HoodPaul/amiga-db23-alternative/README.md

# Amiga DB23 Video and Floppy Adapter

An adapter assembly for the Amiga's motherboard-mounted **DB23 RGB video and external floppy connectors**. A genuine solder-cup DB23 joins a small horizontal PCB, 23 supported straight pins and a solid printed base. Two screws clamp the assembly through the original motherboard mounting holes, with nuts above the adapter PCB and insulating washers under the motherboard-side heads. An optional cosmetic cover locates on the front towers and can be secured with tiny glue spots. **Mechanical/assembly revision: 0.6. PCB revision: 0.5.**

Project development: **Paul of UK Computing Limited**, **Jon of JMC Electronics** and **AI assistance through Codex**. This develops Paul's supplied straddle-PCB concept and supported loose-pin construction.

Repository: [HoodPaul/amiga-db23-alternative](https://github.com/HoodPaul/amiga-db23-alternative).

**Status, 30 October 2026: fit prototype. Paul has trial-printed revision 0.5 and reported delicate lid projections and nuts contained within the print footprint. The revised 0.6 parts have not yet been printed. The complete connector, fastener and PCB stack remains unmeasured. No physical strength, assembled electrical operation or Amiga compatibility test has been completed.** Native files and trial prints make those checks possible; this is not a production release.

For engineering or AI work, read [AGENTS.md](AGENTS.md), the [handover](docs/AI-HANDOVER.md) and [documentation index](docs/README.md).

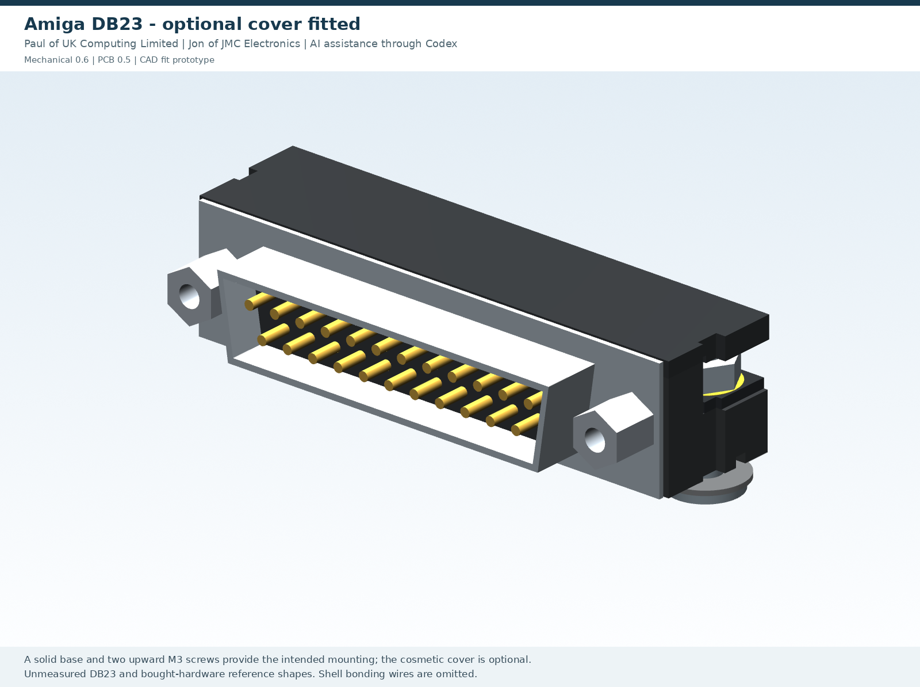
[picture p1: previews/assembly-isometric.png]
Assembly with black cap

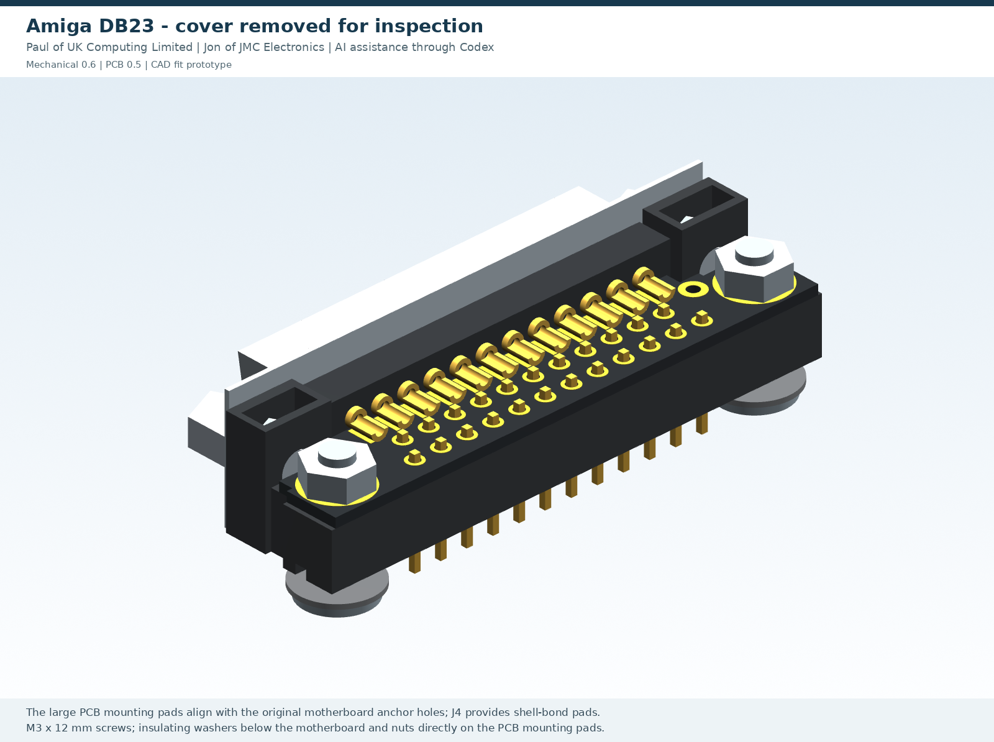
[picture p2: previews/assembly-cap-removed.png]
Assembly with cap removed

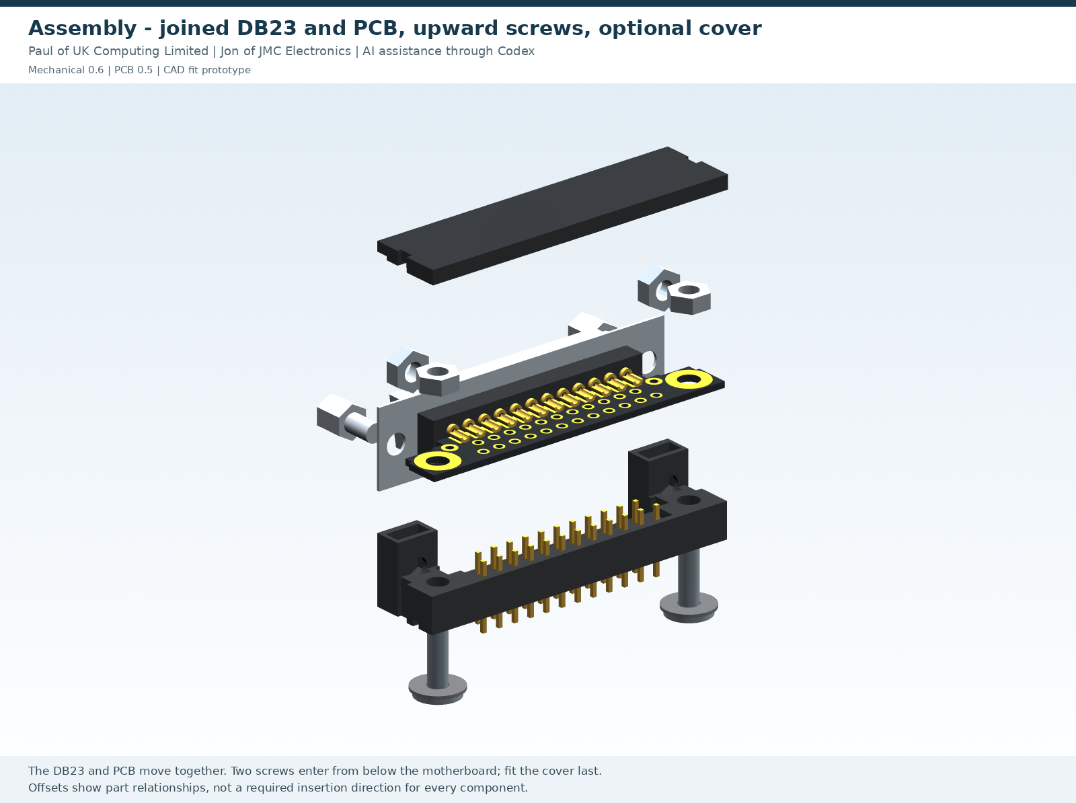
[picture p3: previews/assembly-exploded.png]
Exploded assembly

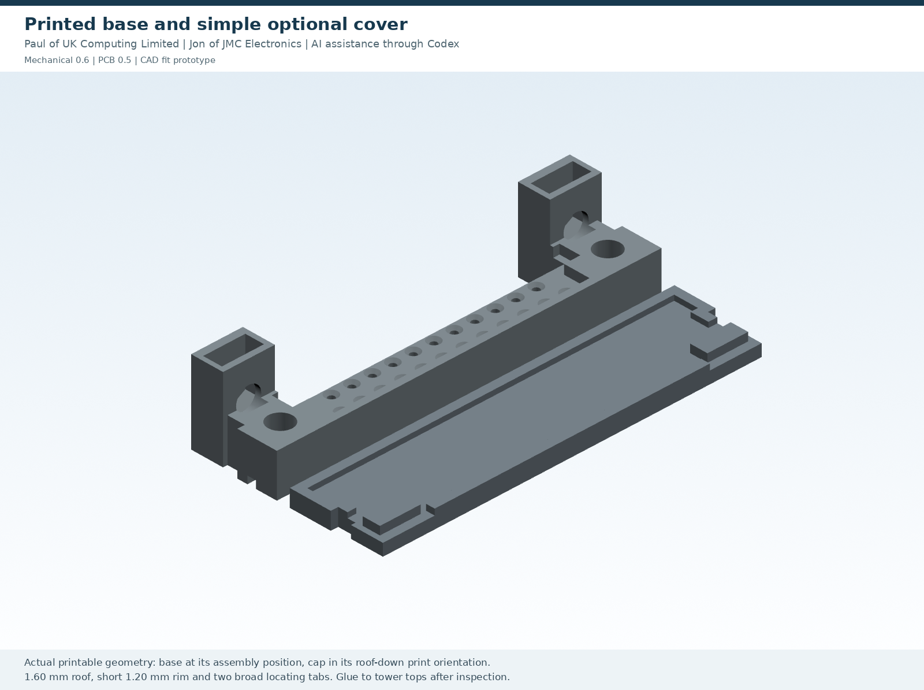
[picture p4: previews/base-and-cap.png]
Solid base and optional cover


The printed geometry comes from the delivered CAD. Bought connector bodies, cups, pins and hardware are unmeasured reference envelopes. Their appearance does not prove a purchased part fits. See the [drawing PDF](previews/DB23_Prototype_Drawings_v0.6.pdf) for fit references and assembly views.

## Revision 0.6 mechanical arrangement

The DB23 cups straddle the front of the PCB: contacts 1–12 solder to the top and 13–23 to the bottom. Twenty-three separate pins pass through the base into the original motherboard signal holes.

The PCB has side ears with plated `SHIELD` mounting lands at the original shell-anchor positions. **M3 screws enter from underneath the motherboard**, pass through the solid base and PCB, and take nuts on top, with insulating washers beneath the screw heads. The printed base has one broad, flat underside at motherboard Z0 and supports the PCB at Z5.75.

The forward towers have straight, square outer faces at X±25.60. Clearance for neighbouring components starts behind the towers.

Dedicated J4 shell-bond pads keep wire and solder away from the J3 nut-bearing lands. The cap fits last, after mounting and inspection. It provides the discreet black appearance; fitted jackposts must retain their nuts with the cover absent. The solid base and through-bolts carry the intended cable loads. Actual insertion strength and clamping behaviour remain untested.

The build order follows four parts: **join DB23 and PCB; load pins with the separate height jig and solder the joined assembly onto them; fit jackpost nuts and posts; mount and solder to the motherboard, inspect, then fit the cap.** See the [assembly guide](docs/ASSEMBLY.md).

## PCB variants

Open the matching project with **KiCad 7.0 or newer**:

| Variant | Native project | Connector on the Amiga |
|---|---|---|
| RGB video | [DB23M_RGB.kicad_pro](pcb/DB23M_RGB/DB23M_RGB.kicad_pro) | Male DB23 solder-cup connector |
| External floppy | [DB23F_Floppy.kicad_pro](pcb/DB23F_Floppy/DB23F_Floppy.kicad_pro) | Female DB23 solder-cup connector |

Local symbols and footprints are included. Male and female pin numbering is mirrored; use the matching PCB.

| PCB property | Revision 0.5 |
|---|---|
| Overall board envelope | **51.20 × 9.00 mm**, Y4.00–13.00, with mounting ears, front clearance steps and local reliefs |
| Layers / assumed thickness | **Two / 1.00 mm**; confirm the actual cup gap |
| Proposed finish | Black mask, white silkscreen, ENIG exposed pads |
| PCB legend, both faces | **Amiga DB23 REV 0.5**, nominal 0.70 mm text height / 0.10 mm stroke |
| Signal track / clearance | **0.50 / 0.20 mm** |
| Tail drill / pad | **1.04 / 1.70 mm** |
| J3 mounting drill / pad | **3.30 / 6.50 mm** |
| J4 shell-wire drill / pad | **1.20 / 2.40 mm** |
| Along-row pitch / spacing / stagger | **2.77 / 2.84 / 1.385 mm** |
| Front / rear signal rows | **Y8.08 / Y10.92 mm** from flange datum |
| Shell mounting centres | **44.27 mm**, at **Y9.50 mm** |
| Nominal mating centreline | **6.25 mm** above the motherboard |

The hole pattern and mating references are nominal values from the [iComp OEM-equivalent drawings](docs/SOURCES.md). The PCB rear is now Y13.00 rather than Y16.00, 3.00 mm shorter than revision 0.4. The cap reaches Y13.20, 0.70 mm behind the OEM reference rear at Y12.50. The prints are 52.00 mm wide, but the pair of Ø8 underside washers spans 52.27 mm. Actual side-exiting wire and case/component clearance still need checking on the target motherboard.

## Printed parts and mounting hardware

The [mechanical folder](mechanical/) contains editable OpenSCAD and the following trial parts:

- [Solid base STL](mechanical/DB23_Holder_v0.6.stl) and [STEP](mechanical/DB23_Holder_v0.6.step).
- [Optional cover STL](mechanical/DB23_Cap_v0.6.stl) and [STEP](mechanical/DB23_Cap_v0.6.step).
- [Pin-height jig](mechanical/DB23_Pin_Height_Jig_v0.6.stl) and [hole-fit coupon](mechanical/DB23_Hole_Fit_Coupon_v0.6.stl).

Read [mechanical notes](docs/MECHANICAL.md) and `mechanical/MECHANICAL_NOTES.txt` for orientations and fit allowances. The cap STL is already roof-down for printing; its STEP uses assembly coordinates. The base has a broad, flat Z0 underside for direct bed placement, subject to the usual first-layer and dimensional trial.

All 23 guides now have **0.40 mm deep, 45° entry funnels**, opening to **Ø1.72 mm** at the surface. This is two layers at 0.20 mm layer height, with the straight retaining bore preserved below. The cover has a **1.60 mm roof**, a short **1.20 mm rim**, and two broad locating tabs. The four thin projections, two hooks and their base catches are removed; obsolete clip coupons are removed too.

The default guides are nominally **Ø0.92 mm** for assumed **0.64 mm square pins**. Their diagonal is about **0.905 mm**, so a finished Ø0.80 mm round bore is too small. Establish snug pin retention using the coupon and actual pins. Use the funnel to guide careful hand clearing with a pin vice if needed. Hot insertion is unvalidated and can move or soften the guide. The loading jig sets a common lower-tip stop; equal upper heights also need equal pin lengths. Remove the jig before soldering.

The default motherboard fastener is **M3 × 12 mm under-head length**, with a user-listed **Ø7 mm, approximately 1 mm thick head**. Fit a **Ø8 mm insulating washer, assumed 0.50 mm thick, beneath each head**; the top nut bears directly on its supported J3 land. With an assumed 1.60 mm motherboard and 2.40 mm nut, the stack takes 11.25 mm, leaving 0.75 mm beyond the nut. The screw tip is Z9.90 and the head bottom Z−3.10, 1.50 mm beneath the assumed motherboard underside. Measure the real stack and underside/chassis clearance. **14 and 16 mm screws require trimming or separately checked cap clearance.** A top washer is not part of the default stack and needs a separate length check. No motherboard countersinking or drilling is specified.

Port jackposts need **4-40 UNC cable-facing threads** and rear stems matching the captive nuts. Prototype defaults use M3 rear stems and nuts. The clearance passage ends at Y6.20; the conservative permitted stem end is **Y≤6.00 from the flange datum**, before the upward mounting nuts. Select the actual hardware before freezing the print.

## Electrical arrangement and validation

All **23 positions pass independently, pin n to pin n**, using neutral `P01`–`P23` names. The bare PCB keeps `SHIELD` separate from every signal pin, including video pin 13. It adds no buffering, conversion, protection or change to the Amiga interface.

J3 mounting lands and J4 shell-wire pads share `SHIELD`. Provide deliberate wires or metal bonds from the DB23 shell and from J4 to the original motherboard shell-ground pad. The default head washers are insulating, and mounting-bolt contact is not relied upon for motherboard grounding. Plastic provides no grounding.

Use the [current validation record](docs/VALIDATION.md) for actual native DRC, exact-netlist and independent geometry results. Native schematic ERC is not claimed. CAD checks do not establish physical fit, printed strength, heat tolerance or working hardware.

Run the portable PCB audit from the project root:

```sh
python3 source/verify_pcb.py
```

Complete the [measurements](docs/MEASUREMENTS.md) and trial prints before a board order. Generated files under [fabrication/FIT-PROTOTYPE/](fabrication/FIT-PROTOTYPE/) are coordinated prototype exports, not a measured production release.

## Project contents

| Path | Purpose |
|---|---|
| [pcb/](pcb/) | Both KiCad projects and local libraries |
| [mechanical/](mechanical/) | Editable source, print trials and STEP geometry |
| [previews/](previews/) | Assembly, print and PCB views, drawing PDF |
| [docs/](docs/) | Assembly, measurements, design decisions and handover |
| [source/](source/) | Shared parameters, builders and verifiers |
| [verification/](verification/) | Actual native and saved-file reports |
| [BOM.csv](BOM.csv) | Parts and selection assumptions |
| [CHANGELOG.md](CHANGELOG.md) | Revision history |
| [NOTICE.md](NOTICE.md) | Project and third-party notices |

## Universal PCB prototype — ordered 30 October 2026

**Use the universal PCB at your own risk.** A separate [universal prototype package](pcb/DB23_Universal_Prototype/README.md) now includes editable PCB, Gerbers/drills, preview, checks and order records. It retains the existing physical routing, adds VIDEO 1 / FLOPPY 1 markings on both faces, removes other numbers and uses round signal pads. Internal numbering remains the VIDEO reference; actual connector orientation and continuity must be checked.

Paul confirmed ordering 30 boards from JLCPCB on 30 October 2026: two-layer FR-4, 1.00 mm, 1 oz, black mask, white silkscreen, ENIG. Receipt, physical fit and functional operation remain unverified. Native KiCad 10.0.7 DRC reports zero errors/unconnected items and four missing-library warnings; exact checks confirm 23 separate signal connections. This is a standalone board snapshot, not a new coordinated PCB revision or a replacement for the two existing variants.

### Hardware order update — 30 October 2026

Paul confirmed **30 PCBs** (correcting the earlier 20), **100 M3 × 12 mm screws with 7 mm heads**, **100 M3 304 stainless nuts**, and **40 strips of 1×40 L11.5 headers** (nominally 1,600 pins). See [the order details](pcb/DB23_Universal_Prototype/ORDER_RECORD_2026-10-30.md). The selected 11.5 mm pins are intended to be used untrimmed after carrier removal; nominal protrusion above the PCB is 1.55 mm and roof clearance 2.70 mm with the existing jig. Actual dimensions and fit are unverified; main CAD still models 10.70 mm pins. Earlier quoted prices apply to the original 20-board screenshot, not the final 30-board order.
