HoodPaul/amiga-db23-alternative/docs/README.md

# Documentation index

| Document | Purpose |
|---|---|
| [AI-HANDOVER.md](AI-HANDOVER.md) | Current decisions, geometry and remaining work |
| [MEASUREMENTS.md](MEASUREMENTS.md) | Worksheet for actual parts, stack and target Amiga |
| [MECHANICAL.md](MECHANICAL.md) | Solid base, upward mounting, cap, jig and pin fit |
| [ASSEMBLY.md](ASSEMBLY.md) | Four-part assembly and electrical inspection |
| [ELECTRICAL.md](ELECTRICAL.md) | Independent signal circuits and shell grounding |
| [FABRICATION.md](FABRICATION.md) | PCB/print preparation and prototype status |
| [DEVELOPMENT.md](DEVELOPMENT.md) | Coordinated regeneration and checks |
| [VALIDATION.md](VALIDATION.md) | Actual results and outstanding physical checks |
| [SOURCES.md](SOURCES.md) | Primary references and assumption boundaries |

Current mechanical/assembly revision: **0.6**. PCB revision: **0.5**. Start with the [project README](../README.md). The shared [parameters](../source/design_parameters.json) are the coordinate contract for native CAD, printed parts, hardware and previews.

Project development: **Paul of UK Computing Limited**, **Jon of JMC Electronics** and **AI assistance through Codex**.
