HoodPaul/amiga-db23-alternative/pcb/DB23_Universal_Prototype/README.md

# Universal DB23 PCB — experimental prototype

**USE THE UNIVERSAL PCB AT YOUR OWN RISK.** It has not been physically fitted or functionally tested on an Amiga. CAD checks and a PCB order do not establish compatibility or safe operation.

This separate board snapshot is based on PCB revision 0.5. It is intended for either a male RGB video solder-cup connector or a female external-floppy solder-cup connector, with the correct connector orientation. Both faces carry VIDEO 1 and FLOPPY 1 markers at their respective ends; other pin numbers are removed and all signal through-hole pads are round. The centre of each pin-1 label aligns with its rear-row through-hole.

Keep the same physical PCB orientation for either connector: 12-contact cups on the top face, 11-contact cups on the bottom, connector facing outwards. Confirm this against your actual connector. Bottom silkscreen is mirrored for reading from below. Internal pad/net numbers retain the VIDEO reference numbering; they are not floppy connector numbers. No universal schematic is supplied.

## Files and manufacture

- [Editable PCB](DB23_Universal_Prototype.kicad_pcb) and [project settings](DB23_Universal_Prototype.kicad_pro)
- [Manufacturing Gerber/drill ZIP](DB23_Universal_Prototype_Gerbers.zip); individual files in [Gerbers](Gerbers/)
- [Front preview](Preview/front.svg)
- [Order record](ORDER_RECORD_2026-10-30.txt)

Use two-layer FR-4, **1.00 mm thickness**, 1 oz copper. The ordered finish is black mask, white silkscreen and ENIG 1 microinch. Existing variant PCBs and mechanical files are unchanged. This snapshot is not regenerated by the main PCB builder.

## Status — 30 October 2026

Paul confirmed an order for **30 universal prototype PCBs from JLCPCB**. No receipt, delivery, physical fit or functional test is recorded. The screenshot quote was £17.16 for boards plus £1.12 estimated shipping; final payment and order number were not supplied. Quoted build was 3 days and shipping 8–12 business days; these are not confirmed delivery dates.

## Checks and limitations

KiCad 10.0.7 loaded the board and ran native DRC: zero errors and zero unconnected items; four warnings concern the absent DB23_Local footprint library. Embedded footprints are included in the PCB. No geometry or silkscreen violations were reported. Schematic parity and ERC were not run.

[integrity.json](integrity.json) confirms the unchanged 26 tracks and outline, 50 pads and only the intended square-to-round pad change. [connection-check.json](connection-check.json) verifies all 23 independent J1-to-J2 signal nets. [Native DRC report](drc.json) is retained. Exports used kicad-cli pcb export gerbers, drill and svg; DRC used kicad-cli pcb drc --format json. Local commands logged registry/configuration warnings, but output files and the DRC report were produced.

Check actual connector numbering, all 23 end-to-end connections, isolation between signals, separate SHIELD wiring, mechanical clearances and mounting insulation before powering hardware. Retain the deliberate connector-shell and motherboard shell-ground bonds described in the main assembly instructions.

Project development: Paul of UK Computing Limited, Jon of JMC Electronics and AI assistance through Codex.

### Hardware order update — 30 October 2026

Paul confirmed **30 PCBs** (correcting the earlier 20), **100 M3 × 12 mm screws with 7 mm heads**, **100 M3 304 stainless nuts**, and **40 strips of 1×40 L11.5 headers** (nominally 1,600 pins). See [the order details](ORDER_RECORD_2026-10-30.md). The selected 11.5 mm pins are intended to be used untrimmed after carrier removal; nominal protrusion above the PCB is 1.55 mm and roof clearance 2.70 mm with the existing jig. Actual dimensions and fit are unverified; main CAD still models 10.70 mm pins. Earlier quoted prices apply to the original 20-board screenshot, not the final 30-board order.
