HoodPaul/amiga-db23-alternative/source/requirements-previews.txt

# Python dependencies for the mechanical build/audit and CAD previews/PDF.
# CadQuery is required by build_mechanical.py; the independent audit also needs VTK.
# Pillow and ReportLab support previews and drawings. OpenSCAD is installed separately.
# The portable PCB audit uses only Python's standard library.
cadquery>=2.4
vtk>=9.2
Pillow>=10
reportlab>=4
