HoodPaul/amiga-db23-alternative/previews/DB23_Prototype_Drawings_v0.6.pdf

AMIGA DB23 PROJECT

Paul of UK Computing Limited | Jon of JMC Electronics | AI assistance through Codex

# DB23 replacement assembly

Mechanical 0.6 / PCB 0.5: solid printed base and optional cosmetic cover


30 October 2026 | Mechanical 0.6 / PCB 0.5 | Fit prototype | 1 / 5

The revision 0.6 mechanical assembly uses two metal screws from beneath the motherboard, through a solid base and the adapter PCB, with insulating washers below the motherboard and nuts above the adapter PCB. The optional cover conceals the hardware. Fitted jackposts must retain their nuts without the cover; check the actual assembly.

Adapter PCB overall width / depth | 51.20 / 9.00 mm (Y4.00-13.00)
PCB thickness / underside height | 1.00 mm / Z5.75 mm assumed
Printed base width / rear position | 52.00 mm / Y13.00 mm
Printed cap width / rear position | 52.00 mm / Y13.20 mm
Original shell mounting centres | 44.27 mm; Y9.50 mm

OEM comparison: iComp's original-equivalent drawing has a 50.27 mm width and 12.50 mm depth behind the flange datum. The present printed envelope is 52.00 mm wide and reaches Y13.20: +0.865 mm per side and +0.70 mm at the rear. The signal-hole pattern and nominal mating centreline are retained.

Fit prototype: purchased connector, printed fit, clamping, underside clearance and cable-load strength remain unverified. The DB23 body, cups and bought hardware in the views are explicitly assumed reference shapes.

# The two printed parts

A solid base carries the PCB; the optional cover glues to the tower tops

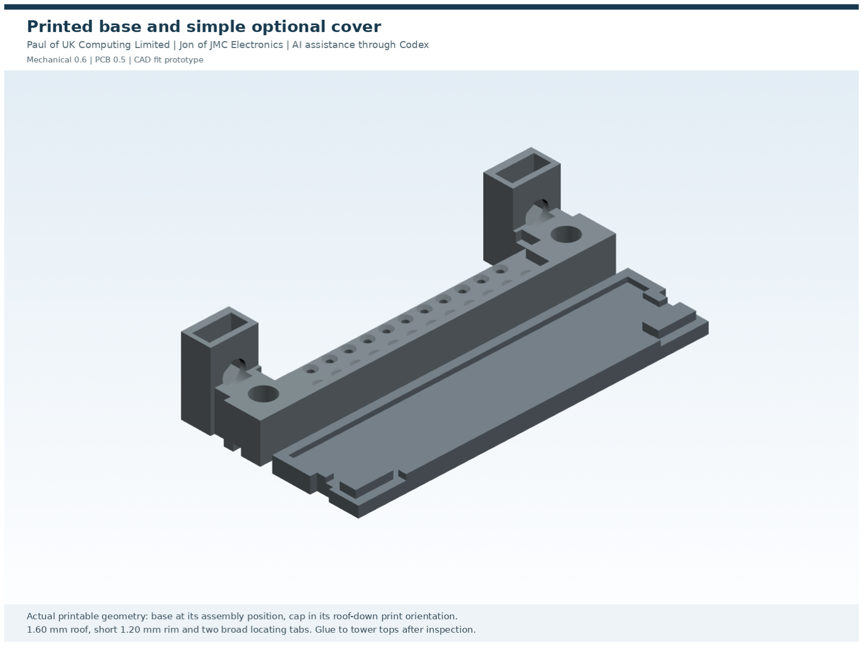
[picture p5: figure]
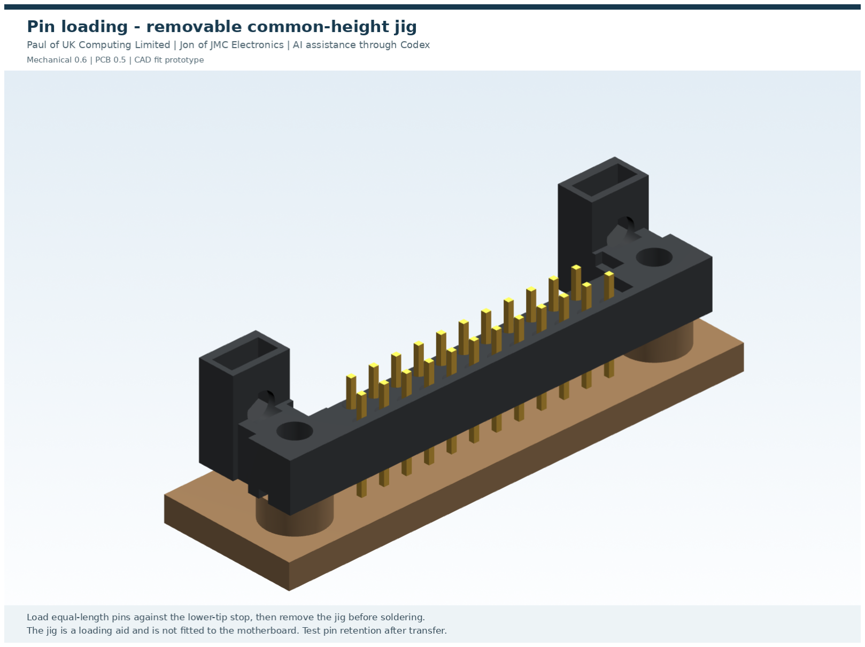
[picture p6: figure]

30 October 2026 | Mechanical 0.6 / PCB 0.5 | Fit prototype | 2 / 5

The squared forward ends have flat X+/-25.60 outer faces, with 0.60 mm added at the former rear-corner rebates. The complete underside is lowered to a coplanar Z0 surface; there are no projecting feet or separate shims. All 23 guide entries have a 0.40 mm deep, 45-degree funnel. The guide retains a 1.25 mm gap below the PCB.

Load the pins first

Print the chamfered hole-fit coupon before the full base. The trial guide diameter is 0.92 mm for assumed 0.64 mm square pins; their diagonal is 0.905 mm. A finished 0.80 mm bore does not clear them.

Use the separate loading jig to set the lower tips. Equal 10.70 mm pins span Z-3.20 to Z7.50. Remove the jig before soldering and check that the base retains the pins.

Printing: the base, cap, jig and hole coupon are trial parts. Follow the mechanical notes for print orientations and cap assembly transforms. The cover has a 1.60 mm roof, 1.20 mm short rim and two broad locating tabs. Four thin projections and both hooks are removed. Trial print fit and tiny glue spots on the tower tops.

# Assembly in four parts

The DB23 and PCB stay joined; upward mounting screws are fitted during installation

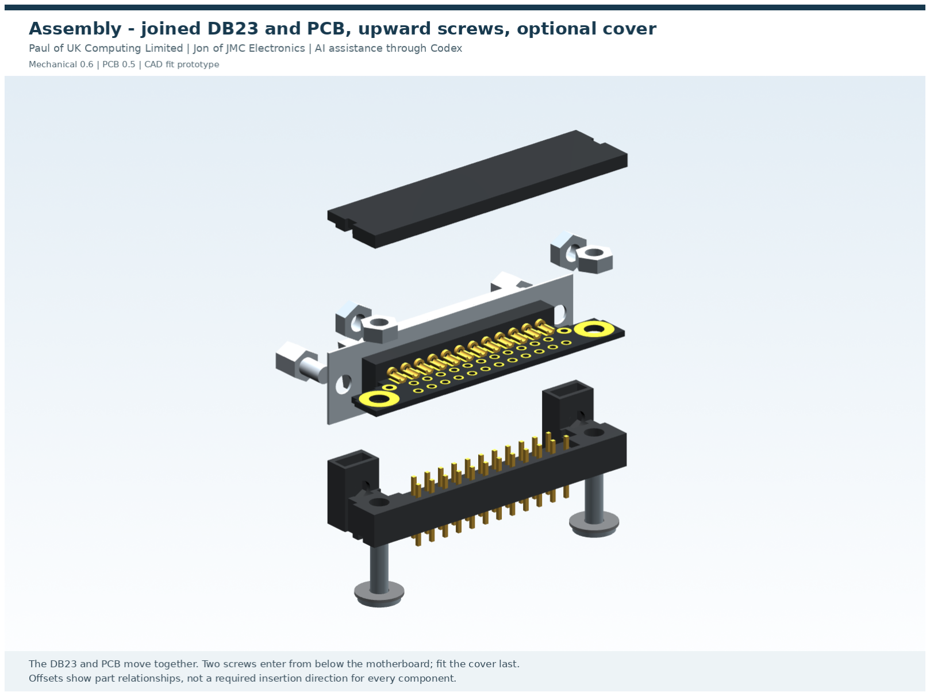
[picture p7: figure]

30 October 2026 | Mechanical 0.6 / PCB 0.5 | Fit prototype | 3 / 5

Part 1 - Join the DB23 and PCB

Identify the matching male or female pin numbers. Solder both rows of cups to the PCB away from the printed base. Prepare the shell bond at the dedicated J4 pads and finish any covered underside joints.

Part 2 - Load pins, then lower the joined assembly

Load equal-length pins into the base using the height jig. Remove the jig, retain the pins in a heat-safe fixture and lower the complete DB23 + PCB from above. Seat the PCB fully, then solder all 23 pin tops.

Part 3 - Fit the jackpost hardware

Insert the jackpost nuts and fit the hex posts through the connector flange. Check actual flange bearing, nut fit and rear stem projection. Leave the decorative cap off while fitting and checking the mounting hardware.

Part 4 - Mount, solder, check, then cap

Check all 23 circuits off the motherboard. Pre-tack the motherboard shell-pad lead with the base removed, then route it through the recessed right-side base channel. Install screws upwards from below, with insulating washers below the motherboard and nuts on the PCB mounting pads. Secure the supported stack, solder the motherboard tails and complete the shell bond. Inspect and test, then optionally attach the cover with tiny glue spots on the tower tops, away from contacts and hardware.

# Upward screw mounting stack

Nominal dimensions only; the actual motherboard, washer and nut must be measured

30 October 2026 | Mechanical 0.6 / PCB 0.5 | Fit prototype | 4 / 5
Motherboard thickness assumed | 1.60 mm
Motherboard top to PCB underside | 5.75 mm
Adapter PCB thickness | 1.00 mm
Underside insulating washer | 0.50 mm
Nut height; no top washer | 2.40 mm
Total under head to top of nut | 11.25 mm

Optional cover roof

M3 x 12 tip: Z9.90

Nut directly on PCB pad

Solid base / supported PCB

Motherboard

Head + insulating washer
Local section enlarged; geometry simplified

### Length selection

Screw length below head | Projection past nut / tip height
12.00 mm - default | 0.75 mm / Z9.90
14.00 mm | 2.75 mm / Z11.90
16.00 mm | 4.75 mm / Z13.90

Cap clearance: the default 12 mm screw ends at Z9.90, below the nominal roof underside at Z11.00. Untrimmed 14 mm and 16 mm screws project into the cover envelope and are not default-compatible. Changing the insulating washer, nut, board thickness or cap geometry requires rechecking the complete stack.

Original holes only: the 7 mm head sits over an 8 mm insulating washer. Allow 1.50 mm total projection below the motherboard. Verify chassis and copper clearance; the shell bond remains a separate wire connection. The washer pair spans 52.27 mm: 0.135 mm beyond each side of the 52 mm print. Do not countersink the motherboard. Wire routing and actual chassis clearance still need a fit check.

# Pin templates and fit worksheet

Print this page at 100% / Actual size with no page scaling

30 October 2026 | Mechanical 0.6 / PCB 0.5 | Fit prototype | 5 / 5

Motherboard top view; connector faces the top of the page

Signal holes and shell anchors retain the original nominal grid. J4 belongs to the adapter only.

MALE / RGB

12 | 1
23 | 13

Blue: adapter outline and J4 holes

FEMALE / FLOPPY

1 | 12
13 | 23

Blue: adapter outline and J4 holes

### 50.00 mm scale check

### Measure before fabrication or final assembly

Purchased DB23 part / gender | ____________________________
Cup gap / cup length / body depth | ____________________________
Actual motherboard / PCB thickness | ____________________________
Pin section / finished bore / retention | ____________________________
Jackpost rear thread / stem projection | ____________________________
Nut AF / thickness / pocket fit | ____________________________
Upward screw / washer / nut stack | ____________________________
Head bearing / underside chassis gap | ____________________________
Cover fit / glue spots / tip clearance | ____________________________
Shell bond / clamping / insertion trial | ____________________________

Coordinate system: X runs across the connector; Y points inward from the flange front plane; Z is measured upward from the motherboard top. Male pin 1 is at positive X in this top view; female numbering is mirrored. The pin pitch is 2.77 mm, row spacing 2.84 mm and row stagger 1.385 mm.

Sources: original nominal connector grid and envelope: iComp DB23 replacement drawings. All selected design choices and unmeasured envelopes are in source/design_parameters.json. See docs/VALIDATION.md for actual saved-file checks and the physical work still outstanding.
