HoodPaul/amiga-db23-alternative/previews/holder-isometric.png

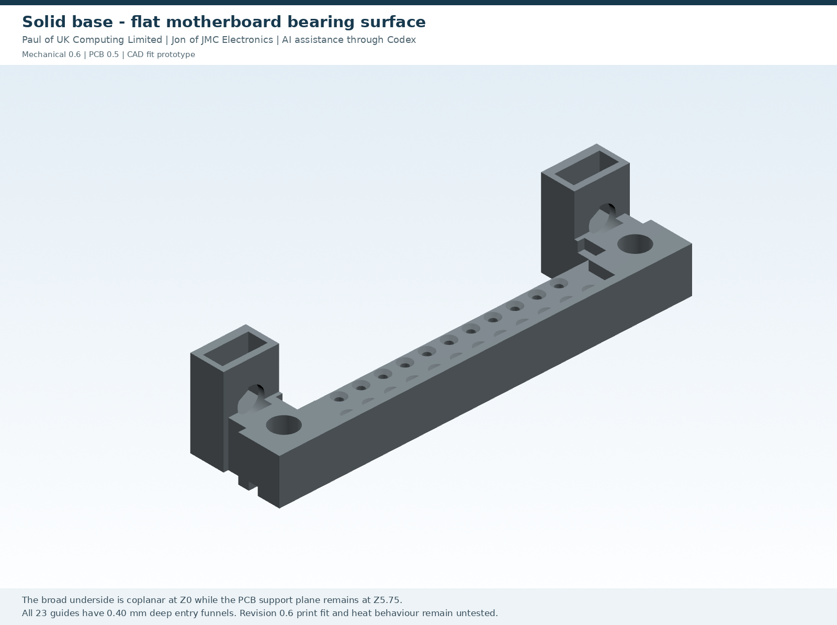
previews/holder-isometric.png
