HoodPaul/amiga-db23-alternative/previews/pcb-female-bottom.png

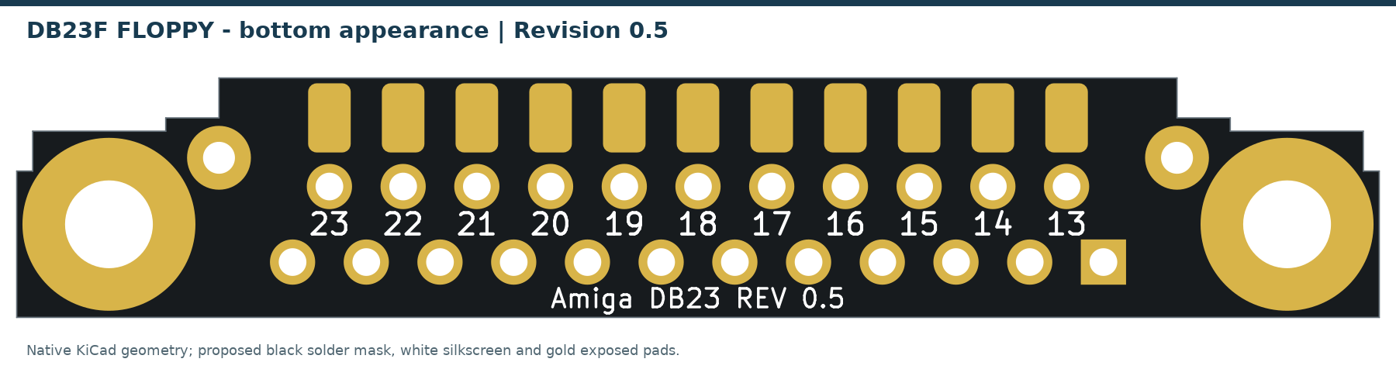
previews/pcb-female-bottom.png
