HoodPaul/amiga-db23-alternative/previews/pcb-female-top.png

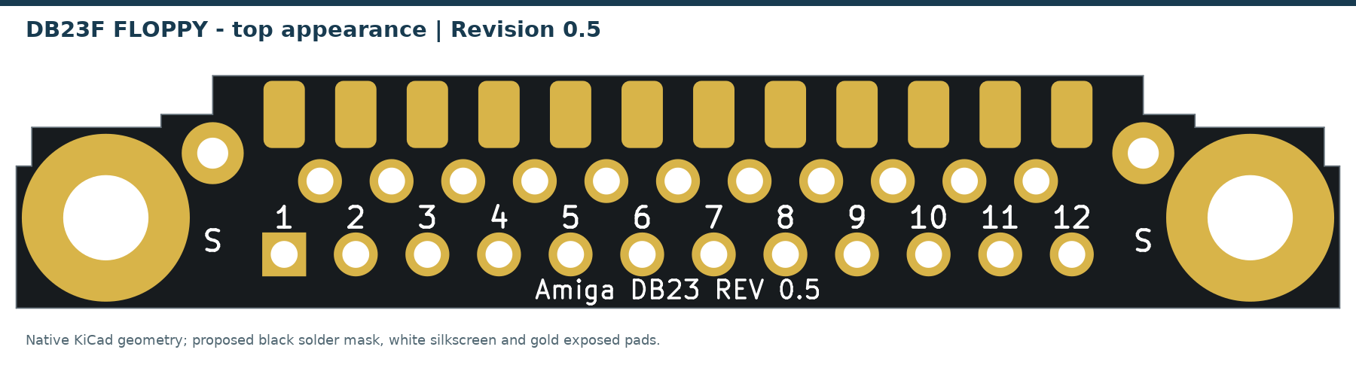
previews/pcb-female-top.png
