HoodPaul/amiga-db23-alternative/previews/pcb-male-bottom.png

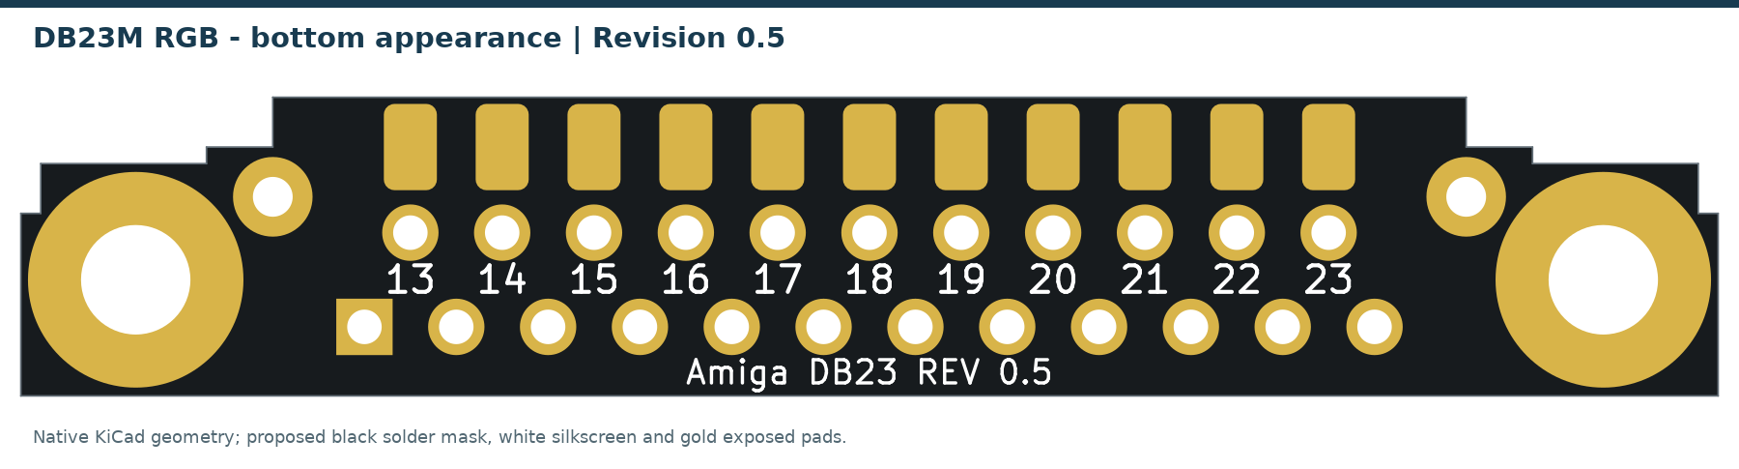
previews/pcb-male-bottom.png
