HoodPaul/amiga-db23-alternative/previews/pcb-male-top.png

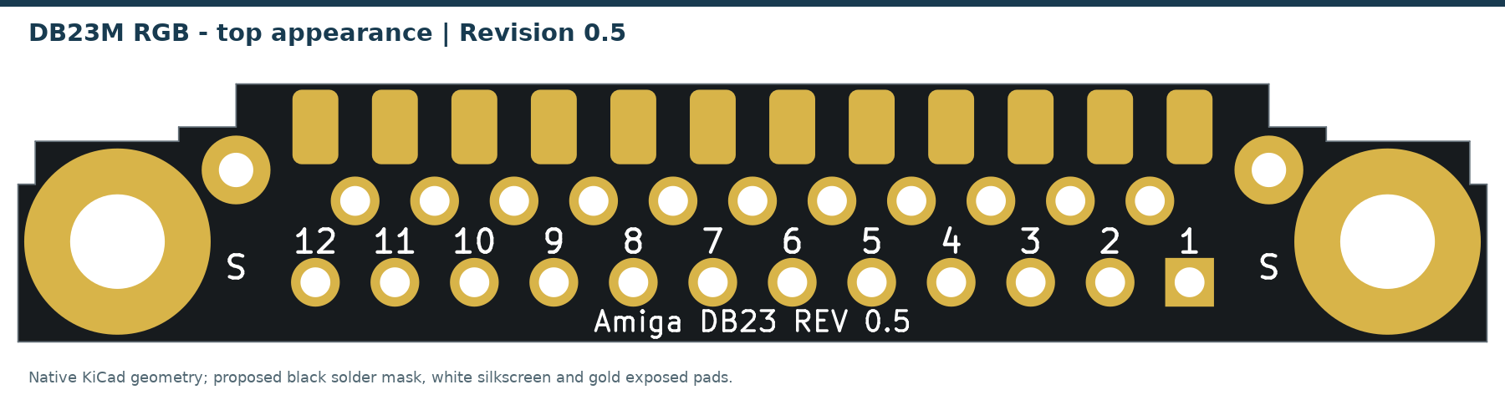
previews/pcb-male-top.png
