HoodPaul/amiga-db23-alternative/previews/pin-height-jig.png

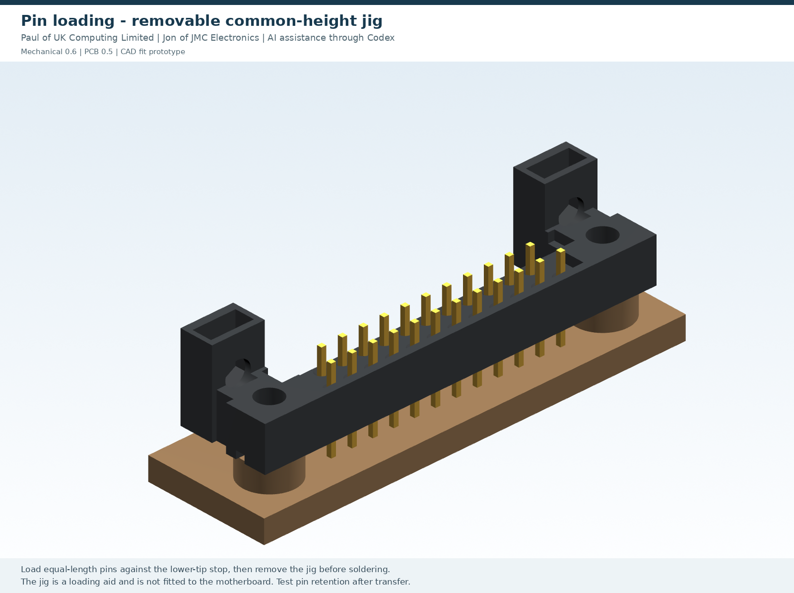
previews/pin-height-jig.png
