HoodPaul/amiga-db23-alternative/pcb/DB23_Universal_Prototype/ORDER_RECORD_2026-10-30.md

# Prototype PCB and hardware orders — 30 October 2026

Orders reported by Paul; receipt and physical checks are pending.

| Item | Selected option | Quantity |
|---|---|---|
| JLCPCB universal PCBs | 51.2 × 9 mm, 2 layers, 1.00 mm FR-4, 1 oz, black mask, white silk, ENIG | **30 boards** |
| [Screws](https://www.aliexpress.com/item/1005009412452370.html) | M3 × 12 mm, 7 mm ultra-thin flat head; nickel-plated steel listing | 2 × 50 = **100 screws** |
| [Hex nuts](https://www.aliexpress.com/item/4000152457370.html) | M3, 304 stainless steel; DIN934 listing | 2 × 50 = **100 nuts** |
| [Pin headers](https://www.aliexpress.com/item/1005008747214913.html) | 1 × 40, 2.54 mm pitch, **L11.5** | 2 × 20 = **40 strips**, nominally **1,600 pins** |

The PCB quantity corrects the earlier record of 20. Earlier quoted PCB and shipping prices relate to the 20-board screenshot and are not the final price for 30 boards. Order numbers, final charges and delivery dates were not supplied. Product options are recorded from Paul's supplied descriptions, not independently verified seller specifications.

## DB23 connector order

Paul also confirmed ordering **5 male and 5 female DB23 connectors** from [this AliExpress listing](https://www.aliexpress.com/item/1005012138133288.html). DB23 was explicitly confirmed after a DB21 typo. This initial quantity supports five video and five floppy prototypes, subject to actual connector fit. Receipt, dimensions and compatibility remain unverified.

## Selected 11.5 mm pins

Use 23 equal-length pins per adapter, untrimmed after removing the plastic carrier. The nominal 0.64 mm square section remains a design assumption to confirm on arrival.

With the existing jig lower-tip stop at Z−3.20, 11.50 mm pins end at Z8.30: **1.55 mm above the nominal PCB top at Z6.75**, leaving **2.70 mm to the lid roof underside at Z11.00**. These are nominal arithmetic clearances, not a physical or regenerated CAD pass. Check solder joints, connector cups and actual lid fit. Main CAD source still models 10.70 mm pins.

Two screws, two nuts and 23 pins are required per adapter: these quantities cover 30 boards with spares. Under-head insulating washers remain required; this update records no washer purchase.

**Use the universal PCB at your own risk.** Connector fit, mounting hardware dimensions, completed assembly and operation remain unverified.
