HoodPaul/amiga-db23-alternative/mechanical/DB23_Cap_v0.6_PCB_support.step

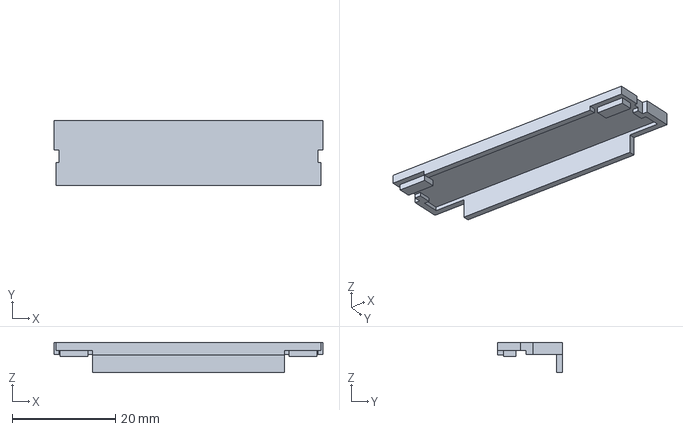
[picture p14: CAD file, 2026-10-30]
mechanical/DB23_Cap_v0.6_PCB_support.step
52.0 x 12.5 x 5.85 mm
