HoodPaul/amiga-db23-alternative/previews/reference-meshes/pcb-reference.stl

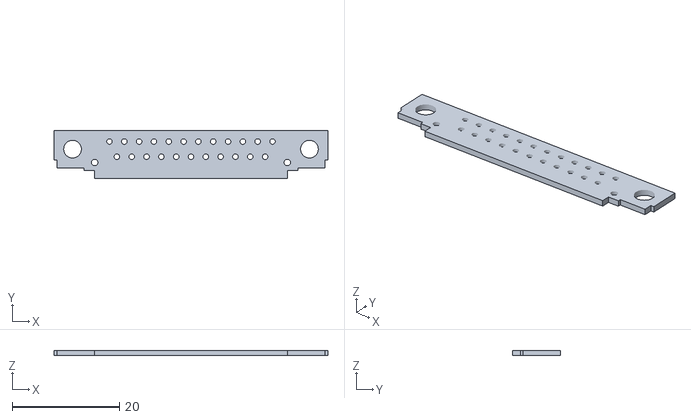
[picture p15: CAD file, 2026-10-29]
previews/reference-meshes/pcb-reference.stl
51.2 x 9.00 x 1.00
