HoodPaul/amiga-db23-alternative/mechanical/DB23_Pin_Height_Jig_v0.6.step

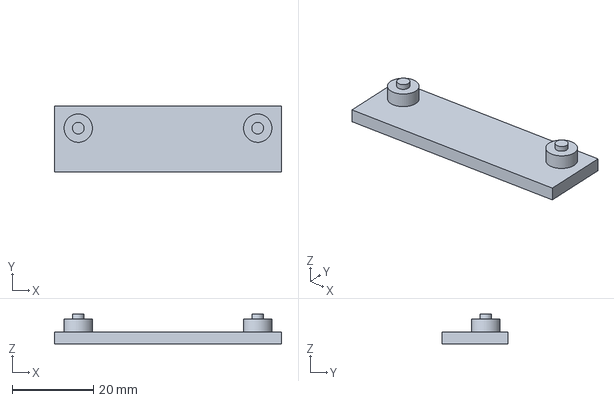
[picture p16: CAD file, 2026-10-30]
mechanical/DB23_Pin_Height_Jig_v0.6.step
56.0 x 16.4 x 7.40 mm
