HoodPaul/amiga-db23-alternative/mechanical/DB23_Holder_v0.6.step

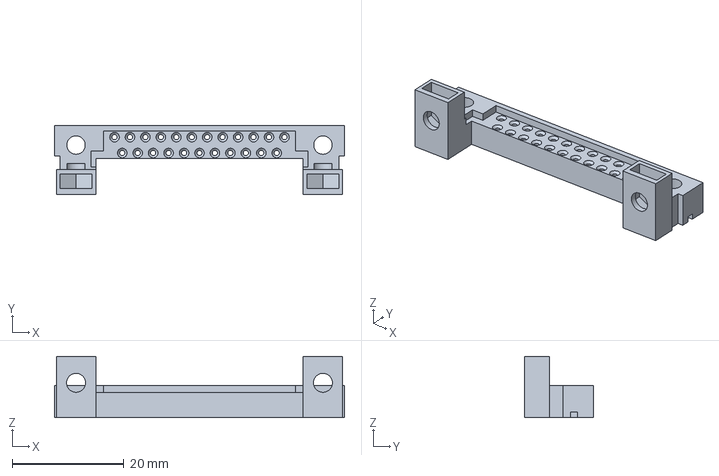
[picture p17: CAD file, 2026-10-30]
mechanical/DB23_Holder_v0.6.step
52.0 x 12.3 x 11.0 mm
