HoodPaul/amiga-db23-alternative/previews/reference-meshes/top-mounting-nuts-reference.stl

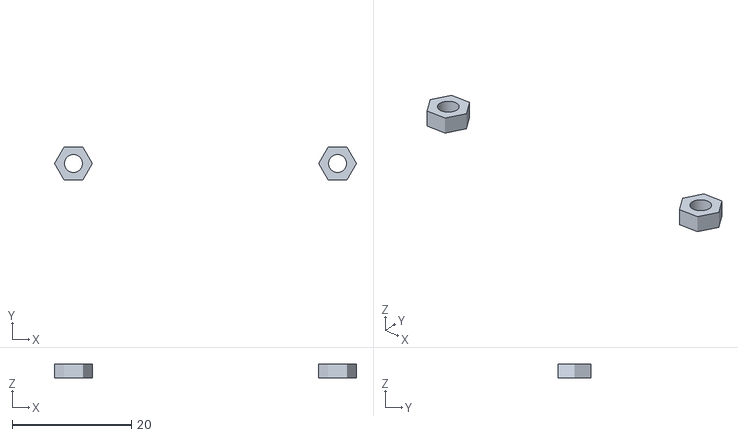
[picture p18: CAD file, 2026-10-29]
previews/reference-meshes/top-mounting-nuts-reference.stl
50.6 x 5.50 x 2.40
