HoodPaul/amiga-db23-alternative/mechanical/DB23_Hole_Fit_Coupon_v0.6.stl

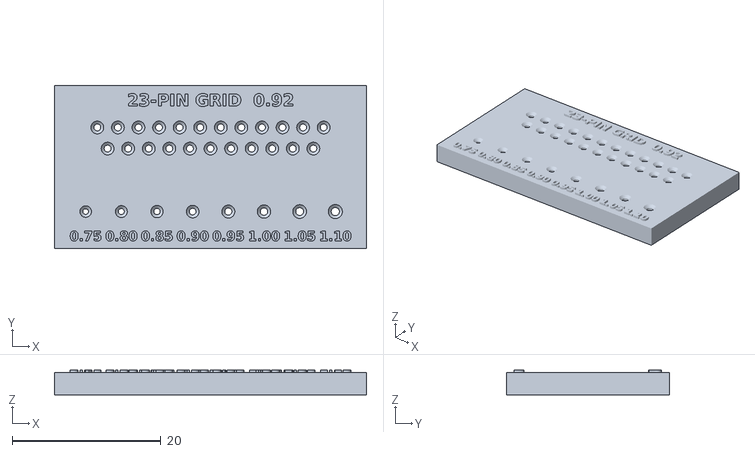
[picture p19: CAD file, 2026-10-30]
mechanical/DB23_Hole_Fit_Coupon_v0.6.stl
42.0 x 22.0 x 3.35
