HoodPaul/amiga-db23-alternative/previews/reference-meshes/jackpost-nuts-reference.stl

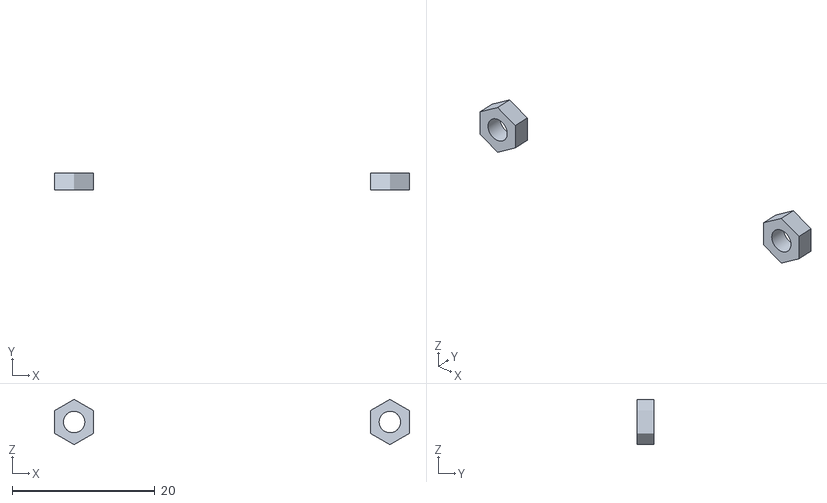
[picture p20: CAD file, 2026-10-29]
previews/reference-meshes/jackpost-nuts-reference.stl
49.8 x 2.40 x 6.35
