HoodPaul/amiga-db23-alternative/mechanical/DB23_Cap_v0.6.step

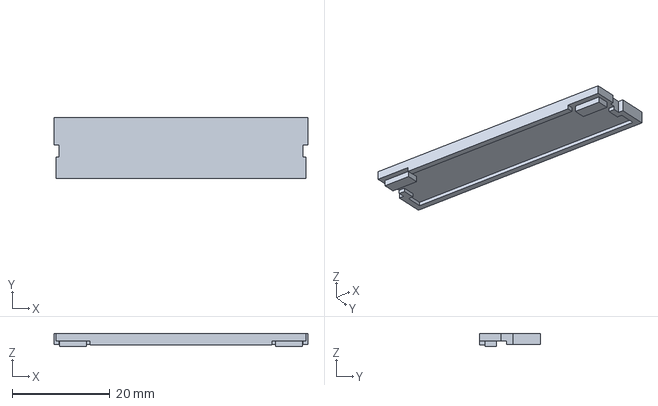
[picture p21: CAD file, 2026-10-30]
mechanical/DB23_Cap_v0.6.step
52.0 x 12.5 x 2.70 mm
