HoodPaul/amiga-db23-alternative/previews/reference-meshes/23-db23-contacts-reference.stl

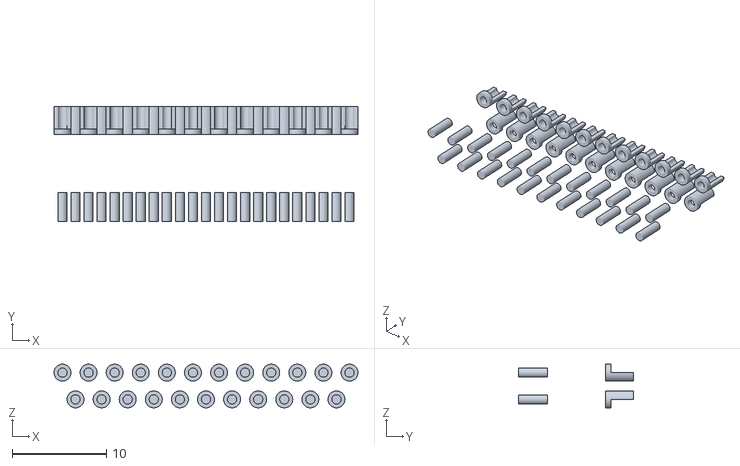
[picture p22: CAD file, 2026-10-29]
previews/reference-meshes/23-db23-contacts-reference.stl
32.3 x 12.2 x 4.64
