HoodPaul/amiga-db23-alternative/previews/reference-meshes/jackposts-reference.stl

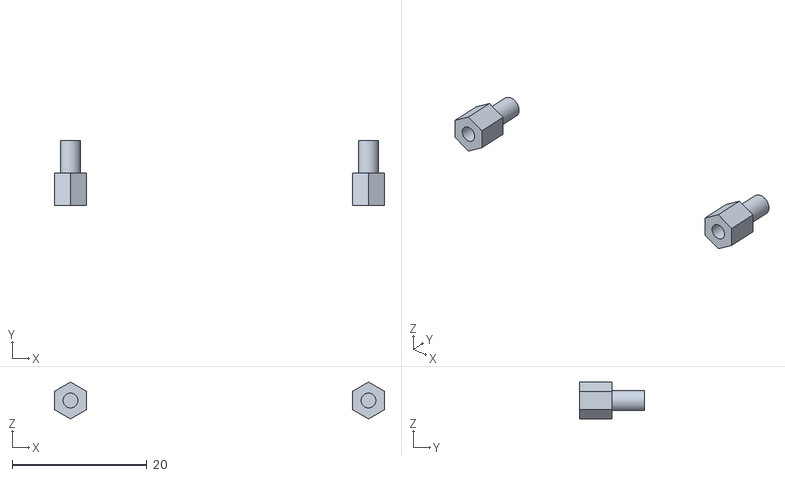
[picture p23: CAD file, 2026-10-29]
previews/reference-meshes/jackposts-reference.stl
49.0 x 9.60 x 5.48
