HoodPaul/amiga-db23-alternative/previews/reference-meshes/db23-metal-reference.stl

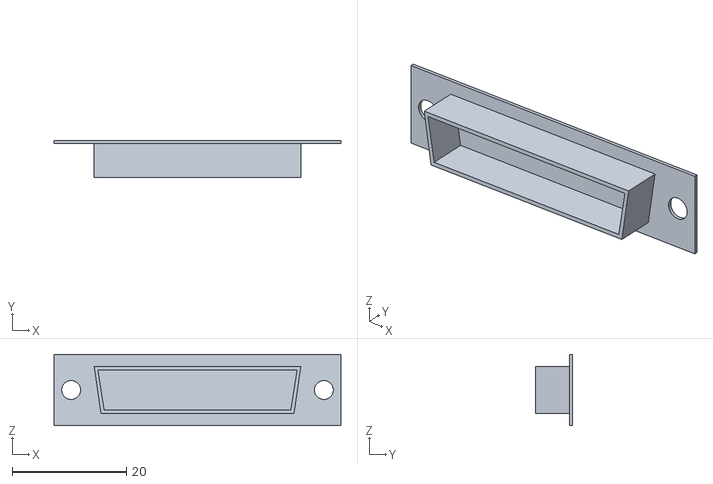
[picture p24: CAD file, 2026-10-29]
previews/reference-meshes/db23-metal-reference.stl
50.3 x 6.50 x 12.5
