HoodPaul/amiga-db23-alternative/previews/reference-meshes/exposed-pad-reference.stl

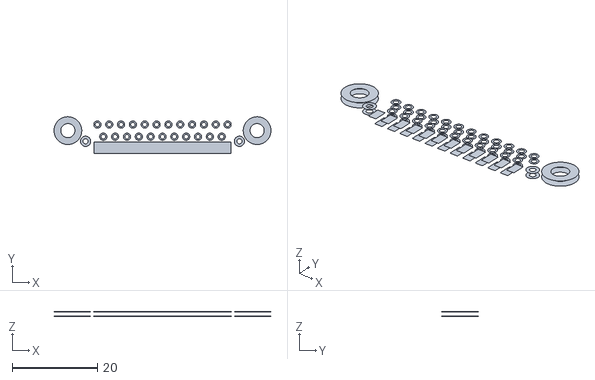
[picture p25: CAD file, 2026-10-29]
previews/reference-meshes/exposed-pad-reference.stl
50.8 x 8.55 x 1.09
