HoodPaul/amiga-db23-alternative/previews/reference-meshes/db23-insulator-reference.stl

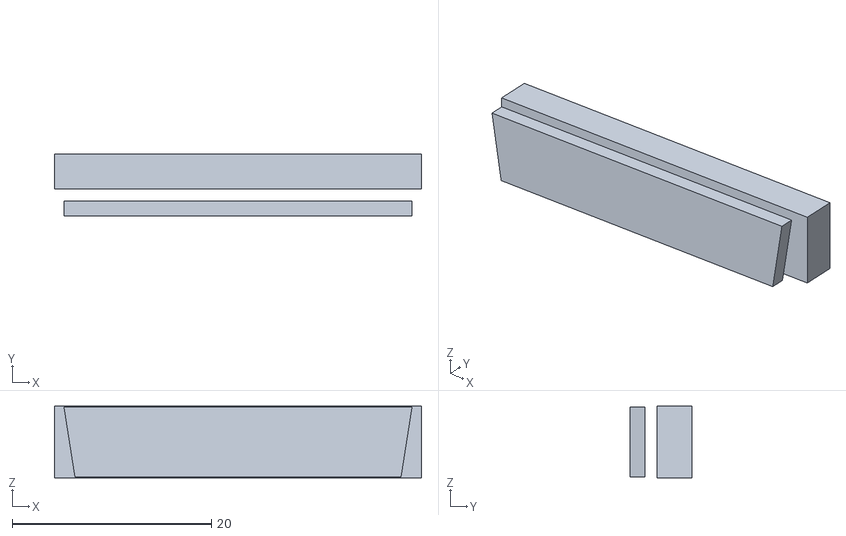
[picture p26: CAD file, 2026-10-29]
previews/reference-meshes/db23-insulator-reference.stl
36.8 x 6.20 x 7.20
