HoodPaul/amiga-db23-alternative/previews/reference-meshes/23-tail-pins-reference.stl

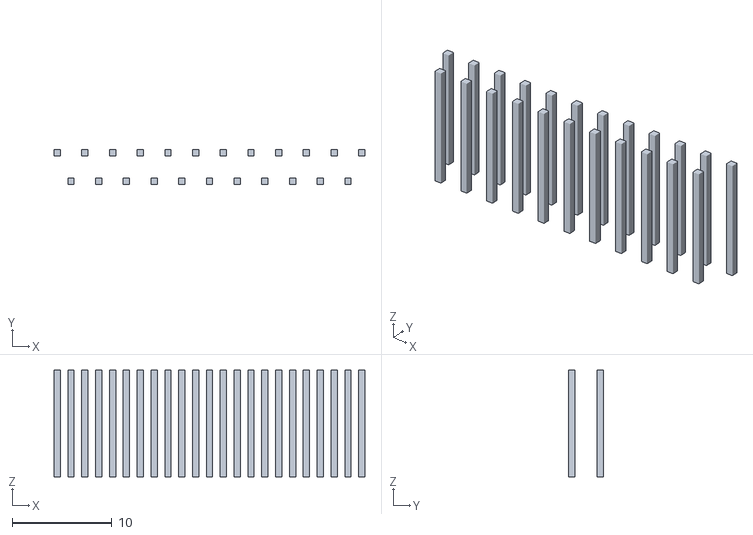
[picture p27: CAD file, 2026-10-29]
previews/reference-meshes/23-tail-pins-reference.stl
31.1 x 3.48 x 10.7
