HoodPaul/amiga-db23-alternative/previews/reference-meshes/upward-M3x12-screws-reference.stl

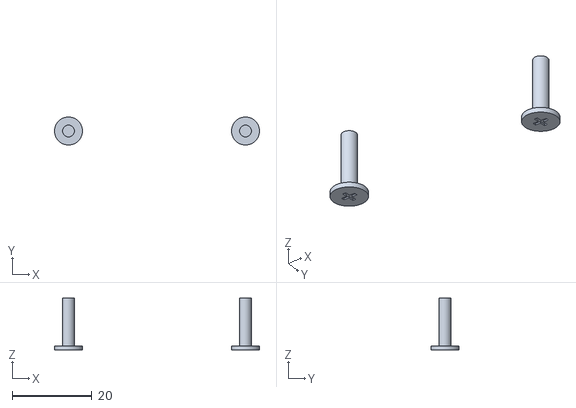
[picture p28: CAD file, 2026-10-29]
previews/reference-meshes/upward-M3x12-screws-reference.stl
51.3 x 7.00 x 13.0
