HoodPaul/amiga-db23-alternative/previews/reference-meshes/underside-insulating-washers-reference.stl

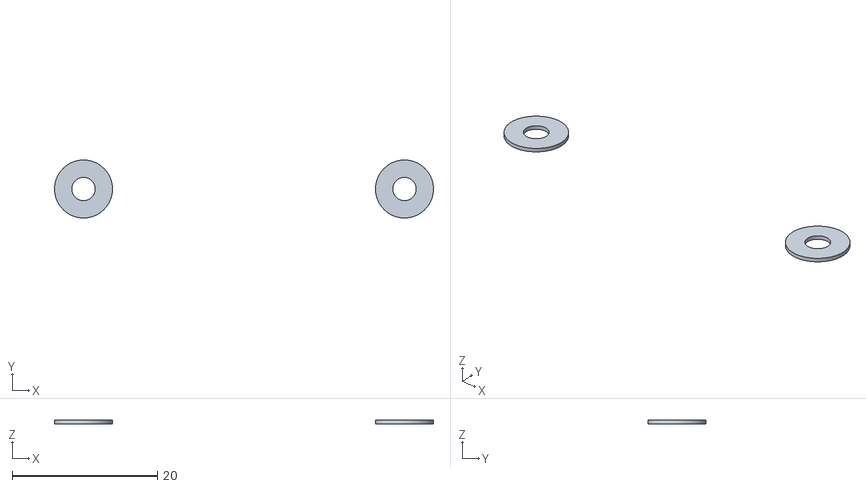
[picture p29: CAD file, 2026-10-29]
previews/reference-meshes/underside-insulating-washers-reference.stl
52.3 x 8.00 x 0.5
