HoodPaul/amiga-db23-alternative/mechanical/DB23_Cap_v0.6_PCB_support.scad

// DB23 v0.6 alternative lid with PCB support wall. Fit prototype.
// Standalone snapshot recovered from the checked central-wall correction.
// Default: roof-down print coordinates. Set assembly=true for STEP alignment.
assembly=false;
module cap_assembly(){
 difference(){
  union(){
   translate([-26.0, 0.65, 11.0]) cube([52.0, 12.549999999999999, 1.5999999999999996]);
   translate([-18.6, 0.65, 10.2]) cube([37.2, 1.2000000000000002, 0.8300000000000001]);
   translate([-26.0, 12.0, 10.3]) cube([52.0, 1.1999999999999993, 0.7299999999999986]);
   translate([-18.6, 12.0, 6.75]) cube([37.2, 1.1999999999999993, 4.279999999999999]);
   translate([-26.0, 7.5, 10.3]) cube([1.1999999999999993, 5.699999999999999, 0.7299999999999986]);
   translate([-25.0, 6.2, 10.3]) cube([1.1999999999999993, 2.499999999999999, 0.7299999999999986]);
   translate([-24.885, 1.8, 9.9]) cube([5.5, 2.4000000000000004, 1.129999999999999]);
   translate([24.8, 7.5, 10.3]) cube([1.1999999999999993, 5.699999999999999, 0.7299999999999986]);
   translate([23.8, 6.2, 10.3]) cube([1.1999999999999993, 2.499999999999999, 0.7299999999999986]);
   translate([19.385, 1.8, 9.9]) cube([5.5, 2.4000000000000004, 1.129999999999999]);
  }
  translate([-26.03, 0.62, 10.270000000000001]) cube([0.4299999999999997, 4.4799999999999995, 2.3599999999999977]);
  translate([-26.03, 5.1, 10.270000000000001]) cube([1.0300000000000011, 2.4000000000000004, 2.3599999999999977]);
  translate([25.6, 0.62, 10.270000000000001]) cube([0.4299999999999997, 4.4799999999999995, 2.3599999999999977]);
  translate([25.0, 5.1, 10.270000000000001]) cube([1.0300000000000011, 2.4000000000000004, 2.3599999999999977]);
 }
}

module cap(){
 translate([0, 0, 12.6]) rotate([180, 0, 0]) {
  difference(){
   union(){
    translate([-26.0, 0.65, 11.0]) cube([52.0, 12.549999999999999, 1.5999999999999996]);
    translate([-18.6, 0.65, 10.2]) cube([37.2, 1.2000000000000002, 0.8300000000000001]);
    translate([-26.0, 12.0, 10.3]) cube([52.0, 1.1999999999999993, 0.7299999999999986]);
    translate([-18.6, 12.0, 6.75]) cube([37.2, 1.1999999999999993, 4.279999999999999]);
    translate([-26.0, 7.5, 10.3]) cube([1.1999999999999993, 5.699999999999999, 0.7299999999999986]);
    translate([-25.0, 6.2, 10.3]) cube([1.1999999999999993, 2.499999999999999, 0.7299999999999986]);
    translate([-24.885, 1.8, 9.9]) cube([5.5, 2.4000000000000004, 1.129999999999999]);
    translate([24.8, 7.5, 10.3]) cube([1.1999999999999993, 5.699999999999999, 0.7299999999999986]);
    translate([23.8, 6.2, 10.3]) cube([1.1999999999999993, 2.499999999999999, 0.7299999999999986]);
    translate([19.385, 1.8, 9.9]) cube([5.5, 2.4000000000000004, 1.129999999999999]);
   }
   translate([-26.03, 0.62, 10.270000000000001]) cube([0.4299999999999997, 4.4799999999999995, 2.3599999999999977]);
   translate([-26.03, 5.1, 10.270000000000001]) cube([1.0300000000000011, 2.4000000000000004, 2.3599999999999977]);
   translate([25.6, 0.62, 10.270000000000001]) cube([0.4299999999999997, 4.4799999999999995, 2.3599999999999977]);
   translate([25.0, 5.1, 10.270000000000001]) cube([1.0300000000000011, 2.4000000000000004, 2.3599999999999977]);
  }
 }
}


if(assembly) cap_assembly(); else cap();
