HoodPaul/amiga-db23-alternative/mechanical/DB23_Holder_v0.6.scad

// DB23 v0.6: FIT PROTOTYPE. CONNECTOR AND PRINT FIT UNMEASURED.
// Generated from source/design_parameters.json by source/build_mechanical.py.
// Holder/STEP coordinates: x across, y rearward, z above motherboard top.
// Cap STL exports roof-down; cap STEP retains assembly coordinates.
// Flat base: all underside bearing faces are coplanar at motherboard Z0.
// There are no projecting mounting feet and no separate printed shims.
// Choose holder, cap, cap_assembly, pin_height_jig or coupon. Default is holder.
part="holder";
$fn=64;
module holder(){
 difference(){
  union(){
   translate([-17.75, 7.1, 0.0]) cube([35.5, 4.9, 4.5]);
   translate([-25.6, 12.0, 0.0]) cube([51.2, 1.0, 5.75]);
   translate([-26.0, 0.65, 0.0]) cube([7.399999999999999, 6.449999999999999, 5.75]);
   translate([-26.0, 7.1, 0.0]) cube([8.75, 5.9, 5.75]);
   translate([-26.0, 0.65, 0.0]) cube([7.399999999999999, 4.449999999999999, 11.0]);
   translate([18.6, 0.65, 0.0]) cube([7.399999999999999, 6.449999999999999, 5.75]);
   translate([17.25, 7.1, 0.0]) cube([8.75, 5.9, 5.75]);
   translate([18.6, 0.65, 0.0]) cube([7.399999999999999, 4.449999999999999, 11.0]);
  }
  translate([-15.235, 10.92, -0.03]) cylinder(d=0.92,h=4.5600000000000005);
  translate([-12.465, 10.92, -0.03]) cylinder(d=0.92,h=4.5600000000000005);
  translate([-9.695, 10.92, -0.03]) cylinder(d=0.92,h=4.5600000000000005);
  translate([-6.924999999999999, 10.92, -0.03]) cylinder(d=0.92,h=4.5600000000000005);
  translate([-4.154999999999999, 10.92, -0.03]) cylinder(d=0.92,h=4.5600000000000005);
  translate([-1.3849999999999998, 10.92, -0.03]) cylinder(d=0.92,h=4.5600000000000005);
  translate([1.3850000000000016, 10.92, -0.03]) cylinder(d=0.92,h=4.5600000000000005);
  translate([4.155000000000001, 10.92, -0.03]) cylinder(d=0.92,h=4.5600000000000005);
  translate([6.925000000000001, 10.92, -0.03]) cylinder(d=0.92,h=4.5600000000000005);
  translate([9.695, 10.92, -0.03]) cylinder(d=0.92,h=4.5600000000000005);
  translate([12.465, 10.92, -0.03]) cylinder(d=0.92,h=4.5600000000000005);
  translate([15.235, 10.92, -0.03]) cylinder(d=0.92,h=4.5600000000000005);
  translate([-13.85, 8.08, -0.03]) cylinder(d=0.92,h=4.5600000000000005);
  translate([-11.08, 8.08, -0.03]) cylinder(d=0.92,h=4.5600000000000005);
  translate([-8.309999999999999, 8.08, -0.03]) cylinder(d=0.92,h=4.5600000000000005);
  translate([-5.539999999999999, 8.08, -0.03]) cylinder(d=0.92,h=4.5600000000000005);
  translate([-2.7699999999999996, 8.08, -0.03]) cylinder(d=0.92,h=4.5600000000000005);
  translate([0.0, 8.08, -0.03]) cylinder(d=0.92,h=4.5600000000000005);
  translate([2.7700000000000014, 8.08, -0.03]) cylinder(d=0.92,h=4.5600000000000005);
  translate([5.540000000000001, 8.08, -0.03]) cylinder(d=0.92,h=4.5600000000000005);
  translate([8.31, 8.08, -0.03]) cylinder(d=0.92,h=4.5600000000000005);
  translate([11.08, 8.08, -0.03]) cylinder(d=0.92,h=4.5600000000000005);
  translate([13.85, 8.08, -0.03]) cylinder(d=0.92,h=4.5600000000000005);
  translate([-15.235, 10.92, 4.1]) cylinder(d1=0.92,d2=1.78,h=0.4300000000000006);
  translate([-12.465, 10.92, 4.1]) cylinder(d1=0.92,d2=1.78,h=0.4300000000000006);
  translate([-9.695, 10.92, 4.1]) cylinder(d1=0.92,d2=1.78,h=0.4300000000000006);
  translate([-6.924999999999999, 10.92, 4.1]) cylinder(d1=0.92,d2=1.78,h=0.4300000000000006);
  translate([-4.154999999999999, 10.92, 4.1]) cylinder(d1=0.92,d2=1.78,h=0.4300000000000006);
  translate([-1.3849999999999998, 10.92, 4.1]) cylinder(d1=0.92,d2=1.78,h=0.4300000000000006);
  translate([1.3850000000000016, 10.92, 4.1]) cylinder(d1=0.92,d2=1.78,h=0.4300000000000006);
  translate([4.155000000000001, 10.92, 4.1]) cylinder(d1=0.92,d2=1.78,h=0.4300000000000006);
  translate([6.925000000000001, 10.92, 4.1]) cylinder(d1=0.92,d2=1.78,h=0.4300000000000006);
  translate([9.695, 10.92, 4.1]) cylinder(d1=0.92,d2=1.78,h=0.4300000000000006);
  translate([12.465, 10.92, 4.1]) cylinder(d1=0.92,d2=1.78,h=0.4300000000000006);
  translate([15.235, 10.92, 4.1]) cylinder(d1=0.92,d2=1.78,h=0.4300000000000006);
  translate([-13.85, 8.08, 4.1]) cylinder(d1=0.92,d2=1.78,h=0.4300000000000006);
  translate([-11.08, 8.08, 4.1]) cylinder(d1=0.92,d2=1.78,h=0.4300000000000006);
  translate([-8.309999999999999, 8.08, 4.1]) cylinder(d1=0.92,d2=1.78,h=0.4300000000000006);
  translate([-5.539999999999999, 8.08, 4.1]) cylinder(d1=0.92,d2=1.78,h=0.4300000000000006);
  translate([-2.7699999999999996, 8.08, 4.1]) cylinder(d1=0.92,d2=1.78,h=0.4300000000000006);
  translate([0.0, 8.08, 4.1]) cylinder(d1=0.92,d2=1.78,h=0.4300000000000006);
  translate([2.7700000000000014, 8.08, 4.1]) cylinder(d1=0.92,d2=1.78,h=0.4300000000000006);
  translate([5.540000000000001, 8.08, 4.1]) cylinder(d1=0.92,d2=1.78,h=0.4300000000000006);
  translate([8.31, 8.08, 4.1]) cylinder(d1=0.92,d2=1.78,h=0.4300000000000006);
  translate([11.08, 8.08, 4.1]) cylinder(d1=0.92,d2=1.78,h=0.4300000000000006);
  translate([13.85, 8.08, 4.1]) cylinder(d1=0.92,d2=1.78,h=0.4300000000000006);
  translate([-22.135, 9.5, -0.03]) cylinder(d=3.3,h=11.059999999999999);
  translate([-22.135, 0.62, 6.25]) rotate([-90,0,0]) cylinder(d=3.4,h=5.58);
  translate([0, 4.3, 0]) rotate([90,0,0]) linear_extrude(2.5999999999999996) polygon([[-19.285, 7.895448267190433], [-22.135, 9.540896534380867], [-24.985000000000003, 7.895448267190433], [-24.985000000000003, 4.604551732809566], [-22.135, 2.959103465619133], [-19.285000000000004, 4.604551732809565]]);
  translate([-24.985000000000003, 1.7, 6.25]) cube([5.700000000000003, 2.5999999999999996, 4.779999999999999]);
  translate([-19.45, 5.55, 4.5]) cube([2.8999999999999986, 2.8999999999999995, 1.2800000000000002]);
  translate([22.135, 9.5, -0.03]) cylinder(d=3.3,h=11.059999999999999);
  translate([22.135, 0.62, 6.25]) rotate([-90,0,0]) cylinder(d=3.4,h=5.58);
  translate([0, 4.3, 0]) rotate([90,0,0]) linear_extrude(2.5999999999999996) polygon([[24.985000000000003, 7.895448267190433], [22.135, 9.540896534380867], [19.285, 7.895448267190433], [19.285, 4.604551732809566], [22.135, 2.959103465619133], [24.985, 4.604551732809565]]);
  translate([19.285, 1.7, 6.25]) cube([5.700000000000003, 2.5999999999999996, 4.779999999999999]);
  translate([16.55, 5.55, 4.5]) cube([2.8999999999999986, 2.8999999999999995, 1.2800000000000002]);
  translate([-26.03, 0.62, -0.03]) cube([0.4299999999999997, 4.4799999999999995, 11.059999999999999]);
  translate([25.6, 0.62, -0.03]) cube([0.4299999999999997, 4.4799999999999995, 11.059999999999999]);
  translate([-26.03, 5.1, -0.03]) cube([1.0300000000000011, 2.4000000000000004, 11.059999999999999]);
  translate([25.0, 5.1, -0.03]) cube([1.0300000000000011, 2.4000000000000004, 11.059999999999999]);
  translate([24.0, 8.9, -0.03]) cube([2.030000000000001, 1.1999999999999993, 1.03]);
 }
}

module cap_assembly(){
 difference(){
  union(){
   translate([-26.0, 0.65, 11.0]) cube([52.0, 12.549999999999999, 1.5999999999999996]);
   translate([-18.6, 0.65, 10.2]) cube([37.2, 1.2000000000000002, 0.8300000000000001]);
   translate([-26.0, 12.0, 10.3]) cube([52.0, 1.1999999999999993, 0.7299999999999986]);
   translate([-26.0, 7.5, 10.3]) cube([1.1999999999999993, 5.699999999999999, 0.7299999999999986]);
   translate([-25.0, 6.2, 10.3]) cube([1.1999999999999993, 2.499999999999999, 0.7299999999999986]);
   translate([-24.885, 1.8, 9.9]) cube([5.5, 2.4000000000000004, 1.129999999999999]);
   translate([24.8, 7.5, 10.3]) cube([1.1999999999999993, 5.699999999999999, 0.7299999999999986]);
   translate([23.8, 6.2, 10.3]) cube([1.1999999999999993, 2.499999999999999, 0.7299999999999986]);
   translate([19.385, 1.8, 9.9]) cube([5.5, 2.4000000000000004, 1.129999999999999]);
  }
  translate([-26.03, 0.62, 10.270000000000001]) cube([0.4299999999999997, 4.4799999999999995, 2.3599999999999977]);
  translate([-26.03, 5.1, 10.270000000000001]) cube([1.0300000000000011, 2.4000000000000004, 2.3599999999999977]);
  translate([25.6, 0.62, 10.270000000000001]) cube([0.4299999999999997, 4.4799999999999995, 2.3599999999999977]);
  translate([25.0, 5.1, 10.270000000000001]) cube([1.0300000000000011, 2.4000000000000004, 2.3599999999999977]);
 }
}

module cap(){
 translate([0, 0, 12.6]) rotate([180, 0, 0]) {
  difference(){
   union(){
    translate([-26.0, 0.65, 11.0]) cube([52.0, 12.549999999999999, 1.5999999999999996]);
    translate([-18.6, 0.65, 10.2]) cube([37.2, 1.2000000000000002, 0.8300000000000001]);
    translate([-26.0, 12.0, 10.3]) cube([52.0, 1.1999999999999993, 0.7299999999999986]);
    translate([-26.0, 7.5, 10.3]) cube([1.1999999999999993, 5.699999999999999, 0.7299999999999986]);
    translate([-25.0, 6.2, 10.3]) cube([1.1999999999999993, 2.499999999999999, 0.7299999999999986]);
    translate([-24.885, 1.8, 9.9]) cube([5.5, 2.4000000000000004, 1.129999999999999]);
    translate([24.8, 7.5, 10.3]) cube([1.1999999999999993, 5.699999999999999, 0.7299999999999986]);
    translate([23.8, 6.2, 10.3]) cube([1.1999999999999993, 2.499999999999999, 0.7299999999999986]);
    translate([19.385, 1.8, 9.9]) cube([5.5, 2.4000000000000004, 1.129999999999999]);
   }
   translate([-26.03, 0.62, 10.270000000000001]) cube([0.4299999999999997, 4.4799999999999995, 2.3599999999999977]);
   translate([-26.03, 5.1, 10.270000000000001]) cube([1.0300000000000011, 2.4000000000000004, 2.3599999999999977]);
   translate([25.6, 0.62, 10.270000000000001]) cube([0.4299999999999997, 4.4799999999999995, 2.3599999999999977]);
   translate([25.0, 5.1, 10.270000000000001]) cube([1.0300000000000011, 2.4000000000000004, 2.3599999999999977]);
  }
 }
}

module pin_height_jig(){
 translate([0, 0, 6.2]) rotate([0, 0, 0]) {
  union(){
   translate([-28.0, -1.35, -6.2]) cube([56.0, 16.35, 3.0]);
   translate([-22.135, 9.5, -3.2]) cylinder(d=7.0,h=3.2);
   translate([-22.135, 9.5, -0.03]) cylinder(d=2.9,h=1.23);
   translate([22.135, 9.5, -3.2]) cylinder(d=7.0,h=3.2);
   translate([22.135, 9.5, -0.03]) cylinder(d=2.9,h=1.23);
  }
 }
}

module coupon(){
 union(){
  difference(){
   translate([-21, 0, 0]) cube([42, 22, 3]);
   translate([-16.8, 5, -0.03]) cylinder(d=0.75,h=3.0599999999999996);
   translate([-12.0, 5, -0.03]) cylinder(d=0.8,h=3.0599999999999996);
   translate([-7.200000000000001, 5, -0.03]) cylinder(d=0.85,h=3.0599999999999996);
   translate([-2.400000000000002, 5, -0.03]) cylinder(d=0.9,h=3.0599999999999996);
   translate([2.3999999999999986, 5, -0.03]) cylinder(d=0.95,h=3.0599999999999996);
   translate([7.199999999999999, 5, -0.03]) cylinder(d=1.0,h=3.0599999999999996);
   translate([11.999999999999996, 5, -0.03]) cylinder(d=1.05,h=3.0599999999999996);
   translate([16.8, 5, -0.03]) cylinder(d=1.1,h=3.0599999999999996);
   translate([-15.235, 16.32, -0.03]) cylinder(d=0.92,h=3.0599999999999996);
   translate([-12.465, 16.32, -0.03]) cylinder(d=0.92,h=3.0599999999999996);
   translate([-9.695, 16.32, -0.03]) cylinder(d=0.92,h=3.0599999999999996);
   translate([-6.924999999999999, 16.32, -0.03]) cylinder(d=0.92,h=3.0599999999999996);
   translate([-4.154999999999999, 16.32, -0.03]) cylinder(d=0.92,h=3.0599999999999996);
   translate([-1.3849999999999998, 16.32, -0.03]) cylinder(d=0.92,h=3.0599999999999996);
   translate([1.3850000000000016, 16.32, -0.03]) cylinder(d=0.92,h=3.0599999999999996);
   translate([4.155000000000001, 16.32, -0.03]) cylinder(d=0.92,h=3.0599999999999996);
   translate([6.925000000000001, 16.32, -0.03]) cylinder(d=0.92,h=3.0599999999999996);
   translate([9.695, 16.32, -0.03]) cylinder(d=0.92,h=3.0599999999999996);
   translate([12.465, 16.32, -0.03]) cylinder(d=0.92,h=3.0599999999999996);
   translate([15.235, 16.32, -0.03]) cylinder(d=0.92,h=3.0599999999999996);
   translate([-13.85, 13.48, -0.03]) cylinder(d=0.92,h=3.0599999999999996);
   translate([-11.08, 13.48, -0.03]) cylinder(d=0.92,h=3.0599999999999996);
   translate([-8.309999999999999, 13.48, -0.03]) cylinder(d=0.92,h=3.0599999999999996);
   translate([-5.539999999999999, 13.48, -0.03]) cylinder(d=0.92,h=3.0599999999999996);
   translate([-2.7699999999999996, 13.48, -0.03]) cylinder(d=0.92,h=3.0599999999999996);
   translate([0.0, 13.48, -0.03]) cylinder(d=0.92,h=3.0599999999999996);
   translate([2.7700000000000014, 13.48, -0.03]) cylinder(d=0.92,h=3.0599999999999996);
   translate([5.540000000000001, 13.48, -0.03]) cylinder(d=0.92,h=3.0599999999999996);
   translate([8.31, 13.48, -0.03]) cylinder(d=0.92,h=3.0599999999999996);
   translate([11.08, 13.48, -0.03]) cylinder(d=0.92,h=3.0599999999999996);
   translate([13.85, 13.48, -0.03]) cylinder(d=0.92,h=3.0599999999999996);
   translate([-15.235, 16.32, 2.6]) cylinder(d1=0.92,d2=1.78,h=0.4299999999999997);
   translate([-12.465, 16.32, 2.6]) cylinder(d1=0.92,d2=1.78,h=0.4299999999999997);
   translate([-9.695, 16.32, 2.6]) cylinder(d1=0.92,d2=1.78,h=0.4299999999999997);
   translate([-6.924999999999999, 16.32, 2.6]) cylinder(d1=0.92,d2=1.78,h=0.4299999999999997);
   translate([-4.154999999999999, 16.32, 2.6]) cylinder(d1=0.92,d2=1.78,h=0.4299999999999997);
   translate([-1.3849999999999998, 16.32, 2.6]) cylinder(d1=0.92,d2=1.78,h=0.4299999999999997);
   translate([1.3850000000000016, 16.32, 2.6]) cylinder(d1=0.92,d2=1.78,h=0.4299999999999997);
   translate([4.155000000000001, 16.32, 2.6]) cylinder(d1=0.92,d2=1.78,h=0.4299999999999997);
   translate([6.925000000000001, 16.32, 2.6]) cylinder(d1=0.92,d2=1.78,h=0.4299999999999997);
   translate([9.695, 16.32, 2.6]) cylinder(d1=0.92,d2=1.78,h=0.4299999999999997);
   translate([12.465, 16.32, 2.6]) cylinder(d1=0.92,d2=1.78,h=0.4299999999999997);
   translate([15.235, 16.32, 2.6]) cylinder(d1=0.92,d2=1.78,h=0.4299999999999997);
   translate([-13.85, 13.48, 2.6]) cylinder(d1=0.92,d2=1.78,h=0.4299999999999997);
   translate([-11.08, 13.48, 2.6]) cylinder(d1=0.92,d2=1.78,h=0.4299999999999997);
   translate([-8.309999999999999, 13.48, 2.6]) cylinder(d1=0.92,d2=1.78,h=0.4299999999999997);
   translate([-5.539999999999999, 13.48, 2.6]) cylinder(d1=0.92,d2=1.78,h=0.4299999999999997);
   translate([-2.7699999999999996, 13.48, 2.6]) cylinder(d1=0.92,d2=1.78,h=0.4299999999999997);
   translate([0.0, 13.48, 2.6]) cylinder(d1=0.92,d2=1.78,h=0.4299999999999997);
   translate([2.7700000000000014, 13.48, 2.6]) cylinder(d1=0.92,d2=1.78,h=0.4299999999999997);
   translate([5.540000000000001, 13.48, 2.6]) cylinder(d1=0.92,d2=1.78,h=0.4299999999999997);
   translate([8.31, 13.48, 2.6]) cylinder(d1=0.92,d2=1.78,h=0.4299999999999997);
   translate([11.08, 13.48, 2.6]) cylinder(d1=0.92,d2=1.78,h=0.4299999999999997);
   translate([13.85, 13.48, 2.6]) cylinder(d1=0.92,d2=1.78,h=0.4299999999999997);
   translate([-16.8, 5, 2.6]) cylinder(d1=0.75,d2=1.61,h=0.4299999999999997);
   translate([-12.0, 5, 2.6]) cylinder(d1=0.8,d2=1.6600000000000001,h=0.4299999999999997);
   translate([-7.200000000000001, 5, 2.6]) cylinder(d1=0.85,d2=1.71,h=0.4299999999999997);
   translate([-2.400000000000002, 5, 2.6]) cylinder(d1=0.9,d2=1.7600000000000002,h=0.4299999999999997);
   translate([2.3999999999999986, 5, 2.6]) cylinder(d1=0.95,d2=1.81,h=0.4299999999999997);
   translate([7.199999999999999, 5, 2.6]) cylinder(d1=1.0,d2=1.86,h=0.4299999999999997);
   translate([11.999999999999996, 5, 2.6]) cylinder(d1=1.05,d2=1.9100000000000001,h=0.4299999999999997);
   translate([16.8, 5, 2.6]) cylinder(d1=1.1,d2=1.9600000000000002,h=0.4299999999999997);
  }
  translate([-16.8, 1.7, 2.99]) linear_extrude(.36) text("0.75",size=1.3,halign="center",valign="center",font="DejaVu Sans:style=Bold");
  translate([-12.0, 1.7, 2.99]) linear_extrude(.36) text("0.80",size=1.3,halign="center",valign="center",font="DejaVu Sans:style=Bold");
  translate([-7.200000000000001, 1.7, 2.99]) linear_extrude(.36) text("0.85",size=1.3,halign="center",valign="center",font="DejaVu Sans:style=Bold");
  translate([-2.400000000000002, 1.7, 2.99]) linear_extrude(.36) text("0.90",size=1.3,halign="center",valign="center",font="DejaVu Sans:style=Bold");
  translate([2.3999999999999986, 1.7, 2.99]) linear_extrude(.36) text("0.95",size=1.3,halign="center",valign="center",font="DejaVu Sans:style=Bold");
  translate([7.199999999999999, 1.7, 2.99]) linear_extrude(.36) text("1.00",size=1.3,halign="center",valign="center",font="DejaVu Sans:style=Bold");
  translate([11.999999999999996, 1.7, 2.99]) linear_extrude(.36) text("1.05",size=1.3,halign="center",valign="center",font="DejaVu Sans:style=Bold");
  translate([16.8, 1.7, 2.99]) linear_extrude(.36) text("1.10",size=1.3,halign="center",valign="center",font="DejaVu Sans:style=Bold");
  translate([0, 20, 2.99]) linear_extrude(.36) text("23-PIN GRID  0.92",size=1.65,halign="center",valign="center",font="DejaVu Sans:style=Bold");
 }
}

if(part=="holder") holder();
if(part=="cap_assembly") cap_assembly();
if(part=="cap") cap();
if(part=="pin_height_jig") pin_height_jig();
if(part=="coupon") coupon();
