HoodPaul/amiga-db23-alternative/(list of files, cad)

Other CAD files:
mechanical/DB23_Pin_Height_Jig_v0.5.step
mechanical/DB23_Holder_v0.3.scad
mechanical/DB23_Holder_v0.5.scad
mechanical/DB23_Cap_v0.6.stl
mechanical/DB23_Cap_v0.6_PCB_support.stl
mechanical/DB23_Holder_v0.6.stl
mechanical/DB23_Pin_Height_Jig_v0.6.stl
