HoodPaul/amiga-db23-alternative/docs/MEASUREMENTS.md

# Measurement worksheet

Record part numbers and measurements before freezing geometry. Measure male RGB and female floppy parts separately; matching mating faces do not establish identical rear mouldings or solder cups.

## Identification

| Item | Record |
|---|---|
| Amiga model, motherboard revision, port and gender | Not yet recorded |
| Solder-cup connector maker / part / source | Not yet selected |
| Jackpost and captive nut maker / part | Not yet selected |
| Upward screw, washer and nut part numbers | User-listed M3 options; not measured |
| Pin source and usable length | Not yet measured |
| Printer / material / nozzle / layer height / orientation | Not yet recorded |

## Connector and jackposts

| Measurement or check | Current assumption / reference | Actual result |
|---|---|---|
| Rear insulator width / height | 36.80 / 7.20 mm | |
| Flange to insulator rear / cup tips | 4.00 / 7.00 mm | |
| Cup outside diameter | 1.80 mm | |
| Cup gap / usable PCB overlap / opening direction | 1.00 mm PCB and 2.60 mm pad overlap assumed | |
| Flange width / height / thickness | 50.27 / 12.50 / 0.50 mm | |
| Flange bearing on cradle | Nominal model gap 0.15 mm; actual unmeasured | |
| Bearing shim if needed | Select from real gap; no fixed shim specified | |
| Flange clamping and cable-force path | Into base and anchors without bending cups/tails | |
| Flange mounting centres | 44.27 mm reference | |
| Jackpost cable-facing thread | 4-40 UNC required | |
| Jackpost rear thread and projection | M3 candidate; stem endY≤6.00, passage toY6.20 | |
| Captive nut AF / thickness / fit | 5.50 / 2.40 mm assumed | |

## Pins and print fit

| Measurement or check | Current assumption / reference | Actual result |
|---|---|---|
| Pin shape / section / diagonal | 0.64 mm square / about 0.905 mm diagonal | |
| Equal usable pin length | 10.70 mm | |
| Lower / upper pin tips | Z−3.20 / Z7.50 mm | |
| Best nominal coupon bore | Ø0.92 mm guide default | |
| Finished drill/reamer diameter and fit | Establish with actual pins/printer | |
| Pin grip after removing jig | Unverified | |
| Jig seat, common stop and release | Unverified | |
| Heights after jig removal and PCB lowering | Unverified | |
| J4 solder fillets and right-side ground-wire groove | Groove1.20 wide x1.00 high; actual wire envelope unverified | |
| Cover tabs, tower-top seating and glue bond | Revision 0.6 untested | |
| Jackpost nuts retained with cover absent | Verify fitted threaded jackposts | |
| Entry funnel / hand clearing / pin retention | 0.40 mm deep, Ø1.72 mouth; Ø0.92 retaining bore | |
| Cap clearance over screws/nuts and shell wire | Unverified | |
| Printed temperature, deflection and creep trial | Unverified | |

A finished Ø0.80 mm bore does not clear an assumed 0.64 mm square pin. The coupon and real pins must determine bore compensation. The cap is a trial fit feature, not a qualified fastener.

## Upward mounting stack

| Part or check | Current assumption | Actual result |
|---|---|---|
| Motherboard thickness | 1.60 mm | |
| Motherboard top to adapter underside | 5.75 mm | |
| Broad flat base contact | Z0; no old loose 0.60 mm shims | |
| Adapter PCB thickness | 1.00 mm | |
| Screw thread / under-head length | M3 / 12.00 mm default | |
| Screw head diameter / thickness | Ø7.00 / about 1.00 mm, user listing | |
| Underside insulating washer OD / ID / thickness | Ø8.00 / 3.20 / 0.50 mm | |
| Optional top washer | Not included in default stack; check separately | |
| Top nut AF / height | 5.50 / 2.40 mm | |
| Total under-head stack through nut | 11.25 mm with above assumptions | |
| Default screw tip / beyond-nut projection | Z9.90 / 0.75 mm | |
| Default screw head bottom | Z−3.10 mm; 1.50 mm below assumed motherboard underside | |
| Optional compression stop height and fit | Match actual support height and base variant | |
| Full nut engagement and spare thread | Unverified | |
| Fourteen/sixteen millimetre screw trim requirement | Separately check; default cap not assumed compatible | |
| Flat PCB-ear support below each nut | Unverified | |
| J4-to-original motherboard ground-pad wire | Required; route in recessed right-side base channel without lifting base | |
| Connector-shell bond | Required; verify continuity | |

## Motherboard and case

| Measurement or check | Nominal reference | Actual result |
|---|---|---|
| Along-row pitch / spacing / stagger | 2.77 / 2.84 / 1.385 mm | |
| Signal hole clear diameter | Ø1.04 drawing reference | |
| Shell-anchor hole clear diameter / centres | Ø3.20 / 44.27 mm | |
| Flange to front / rear signal row | 8.08 / 10.92 mm | |
| Flange to anchor line | 9.50 mm | |
| Mating centreline above motherboard | 6.25 mm | |
| Adapter mounting holes / nominal axes | Ø3.30 atX±22.135, Y9.50; original motherboard remains unchanged | |
| Underside head to pads, traces and chassis | Unverified | |
| Space for base/cap width and rear extent | Prints52.00 wide; rearY13.00 / Y13.20 | |
| Maximum underside washer span | 52.27 mm across both Ø8 washers | |
| Ground wire beyond base channel and side window | Measure actual installed wire/insulation envelope | |
| Neighbouring ports/components and rear panel | Unverified | |
| Original ground pads, both deliberate bonds and continuity | Verify on target board; do not rely on bolt contact | |
| Insertion/extraction load, deflection and retention | Unverified | |

Photographs around CN450 help identify the area to inspect; they do not establish a measured clearance. Retain dimensions, photographs, part numbers and print settings with the next revision.

## Reported revision 0.5 print feedback, 30 October 2026

Paul reported that the lid was too delicate and had missing printed features, and identified four thin projections for removal. He reported that the selected nuts fit within the print footprint; the supplied photo shows a nut on the printed base without the adapter PCB underneath. These are observations, not measured clearance for the completed stack.

Revision 0.6 addresses that feedback with a thicker simple cover, no hooks or catches, and 23 shallow guide funnels. Record its new print, hardware and pin-fit results above. No revision 0.6 physical trial has yet been recorded.
