HoodPaul/amiga-db23-alternative/verification/pin-map.csv

project | amiga_pin | net | cup_reference | cup_pad | tail_reference | tail_pad | x_mm | y_mm | routed_layer
DB23M_RGB | 1 | /P01 | J1 | 1 | J2 | 1 | 15.235 | 10.92 | F.Cu
DB23M_RGB | 2 | /P02 | J1 | 2 | J2 | 2 | 12.465 | 10.92 | F.Cu
DB23M_RGB | 3 | /P03 | J1 | 3 | J2 | 3 | 9.695 | 10.92 | F.Cu
DB23M_RGB | 4 | /P04 | J1 | 4 | J2 | 4 | 6.925 | 10.92 | F.Cu
DB23M_RGB | 5 | /P05 | J1 | 5 | J2 | 5 | 4.155 | 10.92 | F.Cu
DB23M_RGB | 6 | /P06 | J1 | 6 | J2 | 6 | 1.385 | 10.92 | F.Cu
DB23M_RGB | 7 | /P07 | J1 | 7 | J2 | 7 | -1.385 | 10.92 | F.Cu
DB23M_RGB | 8 | /P08 | J1 | 8 | J2 | 8 | -4.155 | 10.92 | F.Cu
DB23M_RGB | 9 | /P09 | J1 | 9 | J2 | 9 | -6.925 | 10.92 | F.Cu
DB23M_RGB | 10 | /P10 | J1 | 10 | J2 | 10 | -9.695 | 10.92 | F.Cu
DB23M_RGB | 11 | /P11 | J1 | 11 | J2 | 11 | -12.465 | 10.92 | F.Cu
DB23M_RGB | 12 | /P12 | J1 | 12 | J2 | 12 | -15.235 | 10.92 | F.Cu
DB23M_RGB | 13 | /P13 | J1 | 13 | J2 | 13 | 13.85 | 8.08 | B.Cu
DB23M_RGB | 14 | /P14 | J1 | 14 | J2 | 14 | 11.08 | 8.08 | B.Cu
DB23M_RGB | 15 | /P15 | J1 | 15 | J2 | 15 | 8.31 | 8.08 | B.Cu
DB23M_RGB | 16 | /P16 | J1 | 16 | J2 | 16 | 5.54 | 8.08 | B.Cu
DB23M_RGB | 17 | /P17 | J1 | 17 | J2 | 17 | 2.77 | 8.08 | B.Cu
DB23M_RGB | 18 | /P18 | J1 | 18 | J2 | 18 | 0.0 | 8.08 | B.Cu
DB23M_RGB | 19 | /P19 | J1 | 19 | J2 | 19 | -2.77 | 8.08 | B.Cu
DB23M_RGB | 20 | /P20 | J1 | 20 | J2 | 20 | -5.54 | 8.08 | B.Cu
DB23M_RGB | 21 | /P21 | J1 | 21 | J2 | 21 | -8.31 | 8.08 | B.Cu
DB23M_RGB | 22 | /P22 | J1 | 22 | J2 | 22 | -11.08 | 8.08 | B.Cu
DB23M_RGB | 23 | /P23 | J1 | 23 | J2 | 23 | -13.85 | 8.08 | B.Cu
DB23F_Floppy | 1 | /P01 | J1 | 1 | J2 | 1 | -15.235 | 10.92 | F.Cu
DB23F_Floppy | 2 | /P02 | J1 | 2 | J2 | 2 | -12.465 | 10.92 | F.Cu
DB23F_Floppy | 3 | /P03 | J1 | 3 | J2 | 3 | -9.695 | 10.92 | F.Cu
DB23F_Floppy | 4 | /P04 | J1 | 4 | J2 | 4 | -6.925 | 10.92 | F.Cu
DB23F_Floppy | 5 | /P05 | J1 | 5 | J2 | 5 | -4.155 | 10.92 | F.Cu
DB23F_Floppy | 6 | /P06 | J1 | 6 | J2 | 6 | -1.385 | 10.92 | F.Cu
DB23F_Floppy | 7 | /P07 | J1 | 7 | J2 | 7 | 1.385 | 10.92 | F.Cu
DB23F_Floppy | 8 | /P08 | J1 | 8 | J2 | 8 | 4.155 | 10.92 | F.Cu
DB23F_Floppy | 9 | /P09 | J1 | 9 | J2 | 9 | 6.925 | 10.92 | F.Cu
DB23F_Floppy | 10 | /P10 | J1 | 10 | J2 | 10 | 9.695 | 10.92 | F.Cu
DB23F_Floppy | 11 | /P11 | J1 | 11 | J2 | 11 | 12.465 | 10.92 | F.Cu
DB23F_Floppy | 12 | /P12 | J1 | 12 | J2 | 12 | 15.235 | 10.92 | F.Cu
DB23F_Floppy | 13 | /P13 | J1 | 13 | J2 | 13 | -13.85 | 8.08 | B.Cu
DB23F_Floppy | 14 | /P14 | J1 | 14 | J2 | 14 | -11.08 | 8.08 | B.Cu
DB23F_Floppy | 15 | /P15 | J1 | 15 | J2 | 15 | -8.31 | 8.08 | B.Cu
DB23F_Floppy | 16 | /P16 | J1 | 16 | J2 | 16 | -5.54 | 8.08 | B.Cu
DB23F_Floppy | 17 | /P17 | J1 | 17 | J2 | 17 | -2.77 | 8.08 | B.Cu
DB23F_Floppy | 18 | /P18 | J1 | 18 | J2 | 18 | -0.0 | 8.08 | B.Cu
DB23F_Floppy | 19 | /P19 | J1 | 19 | J2 | 19 | 2.77 | 8.08 | B.Cu
DB23F_Floppy | 20 | /P20 | J1 | 20 | J2 | 20 | 5.54 | 8.08 | B.Cu
DB23F_Floppy | 21 | /P21 | J1 | 21 | J2 | 21 | 8.31 | 8.08 | B.Cu
DB23F_Floppy | 22 | /P22 | J1 | 22 | J2 | 22 | 11.08 | 8.08 | B.Cu
DB23F_Floppy | 23 | /P23 | J1 | 23 | J2 | 23 | 13.85 | 8.08 | B.Cu
