HoodPaul/amiga-db23-alternative/verification/DB23F_Floppy-schematic.pdf

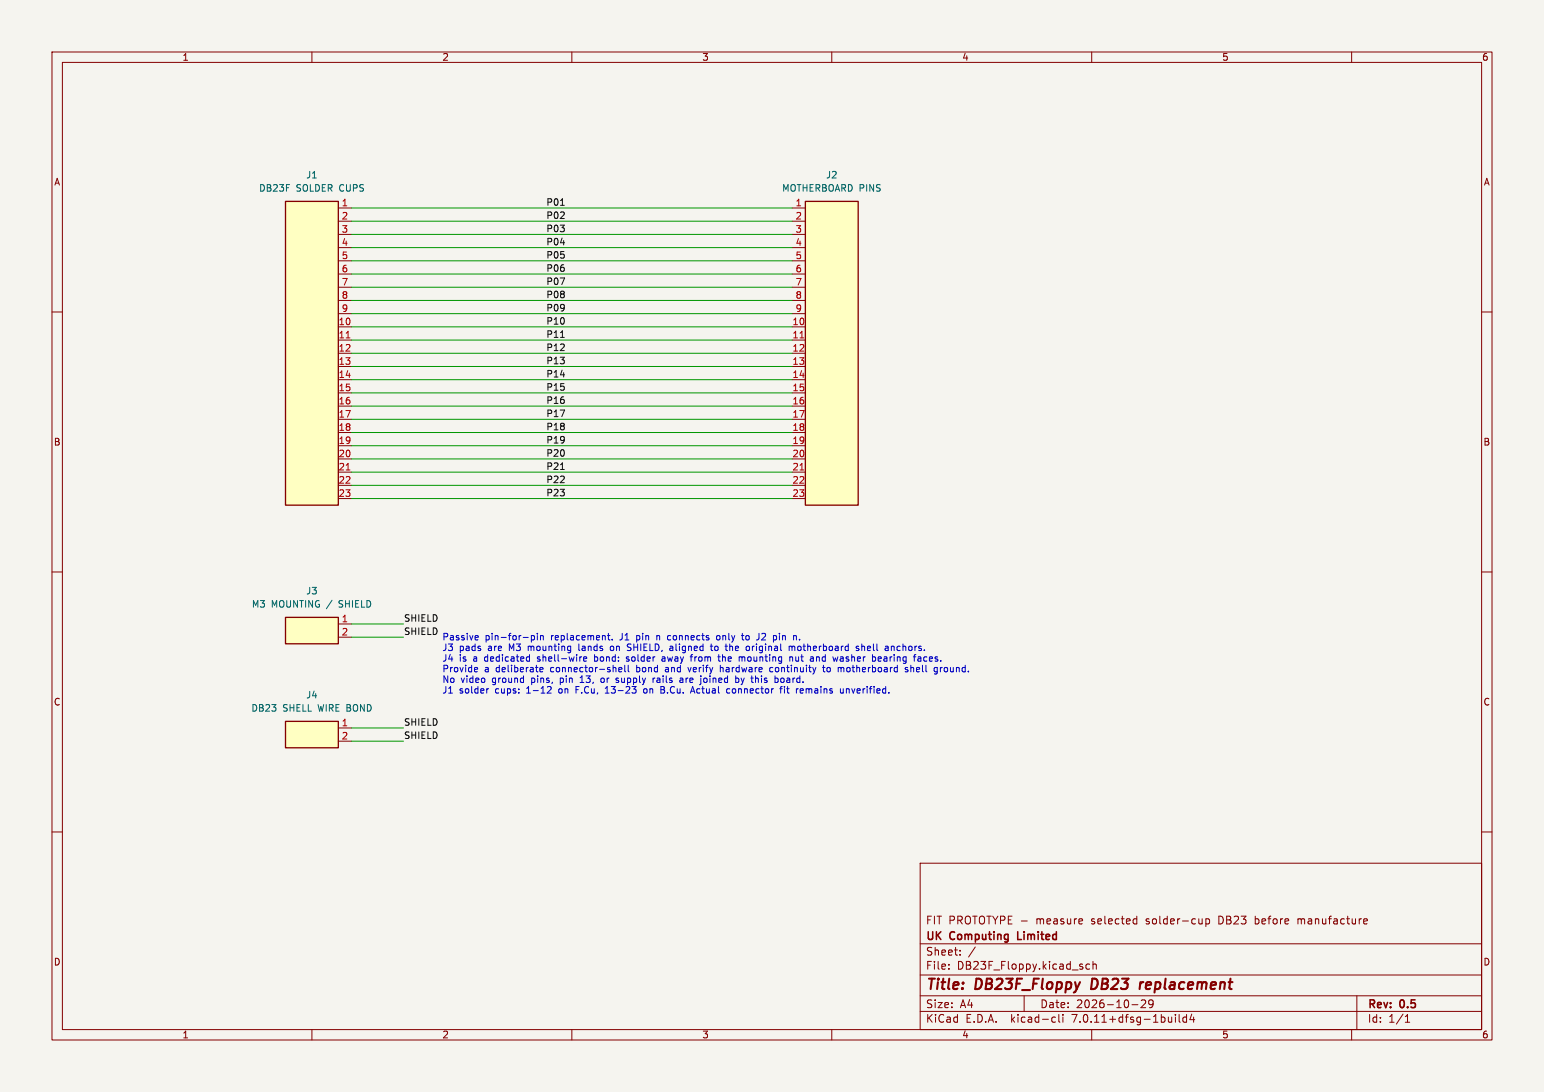
[picture p30: page 1]
