HoodPaul/amiga-db23-alternative/verification/DB23M_RGB-schematic.pdf

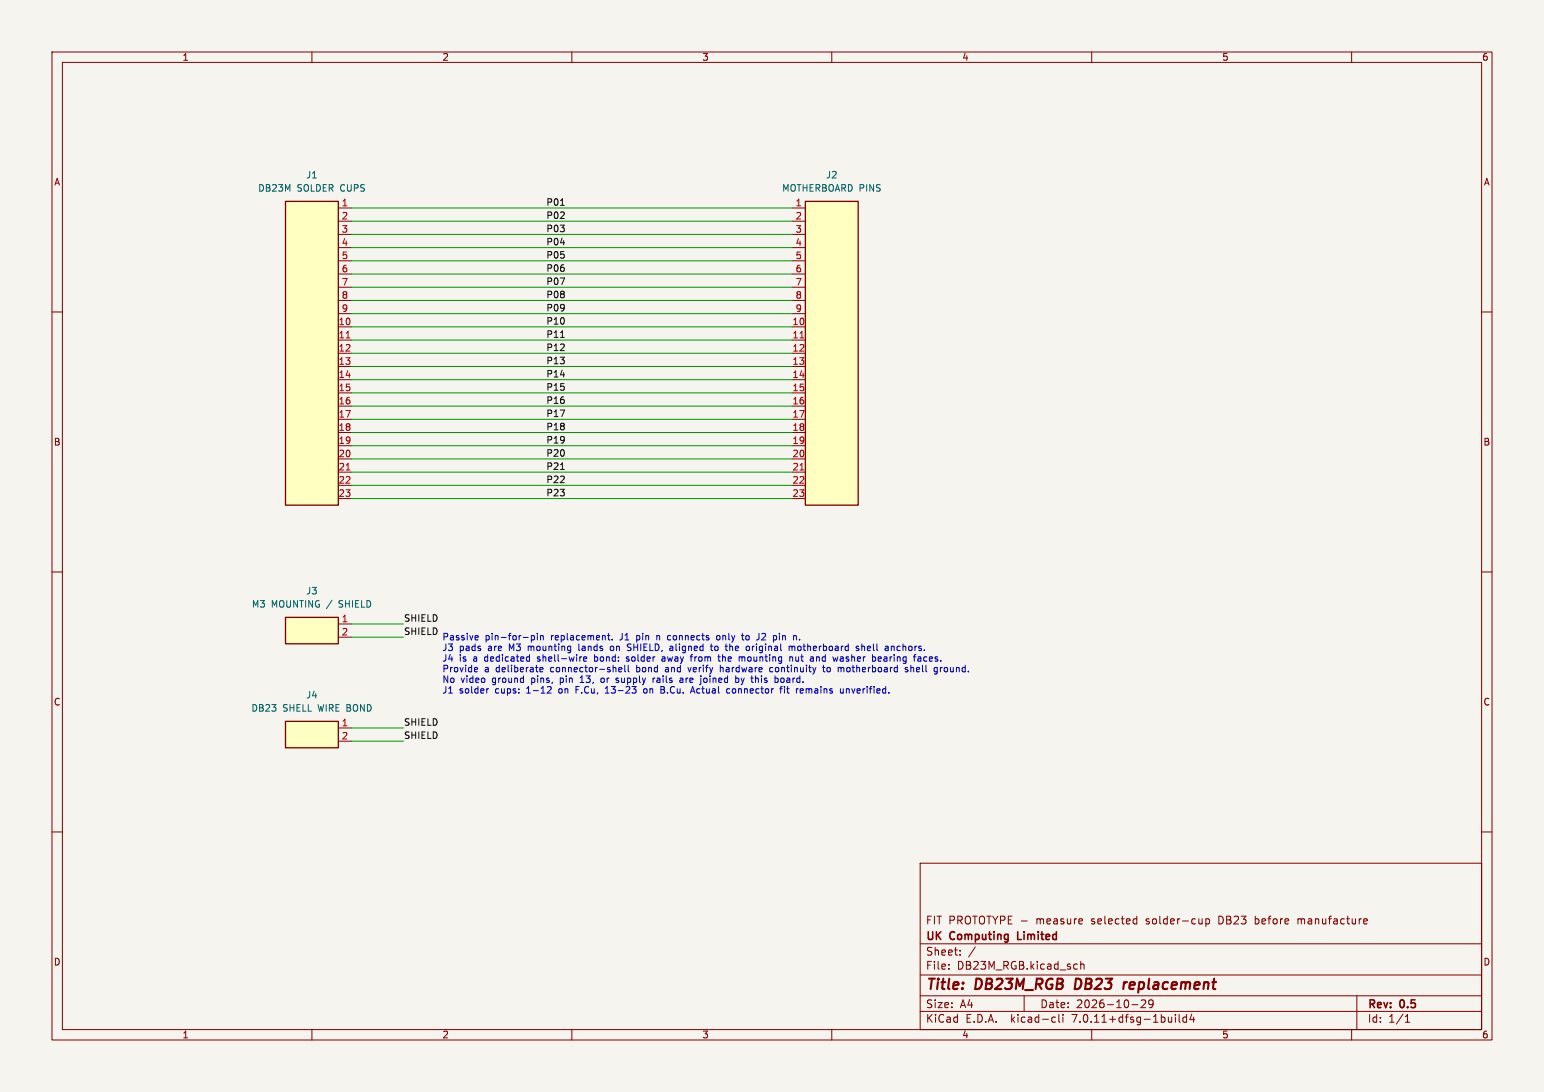
[picture p31: page 1]
