HoodPaul/amiga-db23-alternative/(list of files, drawings)

Other design files:
verification/pcb-build-summary.json
verification/pcb-geometry-review.json
verification/pcb-text-update.json
