HoodPaul/amiga-db23-alternative/pcb/DB23F_Floppy/DB23F_Floppy.kicad_pcb

## KiCad design pcb/DB23F_Floppy/DB23F_Floppy.kicad_pcb (2026-10-30)

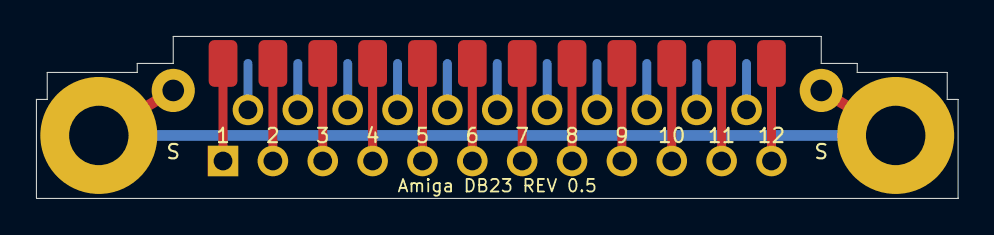
[picture p32: board DB23F_Floppy.kicad_pcb from above]

Board: 2 copper layers, 51.2 x 9.0 mm, 4 parts (0 on the bottom side), 24 nets.

Parts:
J1: DB23F solder cups; Cups23_F
J2: Pins to motherboard; Motherboard23_F
J3: M3 mounting / shield; MountingShield_F
J4: DB23 shell wire bond; ShellBond_F

Connections:
/P01: J1.1, J2.1
/P02: J1.2, J2.2
/P03: J1.3, J2.3
/P04: J1.4, J2.4
/P05: J1.5, J2.5
/P06: J1.6, J2.6
/P07: J1.7, J2.7
/P08: J1.8, J2.8
/P09: J1.9, J2.9
/P10: J1.10, J2.10
/P11: J1.11, J2.11
/P12: J1.12, J2.12
/P13: J1.13, J2.13
/P14: J1.14, J2.14
/P15: J1.15, J2.15
/P16: J1.16, J2.16
/P17: J1.17, J2.17
/P18: J1.18, J2.18
/P19: J1.19, J2.19
/P20: J1.20, J2.20
/P21: J1.21, J2.21
/P22: J1.22, J2.22
/P23: J1.23, J2.23
/SHIELD: J3.1, J3.2, J4.1, J4.2
