HoodPaul/amiga-db23-alternative/(commit log)

2026-10-29 Add DB23 replacement fit prototype v0.3
    Include male RGB and female floppy KiCad projects, printable holder and fit coupon, CAD previews, drawings, BOM and engineering handover.
    Both boards pass native KiCad DRC and the saved-file audit passes 610 checks. Physical connector and printer fit remain unverified.
    [23-db23-contacts-reference.stl, 23-tail-pins-reference.stl, BOM.csv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]
2026-10-29 Strengthen DB23 cradle and add pin-height loading jig
    Raise the end supports, fill the rear opening and recess the motherboard anchor heads in outward-open pockets. Add a separate pin loading jig and document the four-part assembly order, including preloading the anchor bolts before lowering the joined DB23 and PCB.
    Update CAD, printable parts, previews, drawings, BOM and handover for mechanical revision 0.4. Retain electrical PCB revision 0.3 unchanged. Record 117 independent mechanical checks and 610 portable PCB checks. Physical fit and cable-load strength remain untested.
    [BOM.csv, DB23_Anchor_Shim_Single_v0.3.stl, DB23_Anchor_Shim_Single_v0.4.stl, DB23_Anchor_Shims_v0.3.stl, DB23_Anchor_Shims_v0.4.stl, DB23_Holder_v0.3.step, DB23_Holder_v0.3.stl, DB23_Holder_v0.4.scad]
2026-10-29 Add bolted DB23 base and clip-on cap for revision 0.5
    Shorten both adapter PCBs to Y13, add mounting ears at the original shell anchors, and separate the shell-wire pads from the nut-bearing lands. Preserve all 23 independent signal circuits.
    Replace recessed top screw heads with upward M3 mounting screws, a solid printed base with integrated feet, and a keyed black cap. Add clip-fit coupons, updated loading jig, reference-driven corner reliefs and an insulated underside screw-head stack with deliberate shell-ground wiring.
    Regenerate native KiCad projects, fit-prototype manufacturing files, printable STL/STEP, previews, five-page drawings, BOM, assembly guide and AI handover. Both native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
    [23-db23-contacts-reference.stl, BOM.csv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]
2026-10-30 Refine DB23 end walls, PCB labels and project credits
    [DB23F_Floppy-B_Cu.gbl, DB23F_Floppy-B_Mask.gbs, DB23F_Floppy-B_Silkscreen.gbo, DB23F_Floppy-Edge_Cuts.gm1, DB23F_Floppy-F_Cu.gtl, DB23F_Floppy-F_Mask.gts, DB23F_Floppy-F_Silkscreen.gto, DB23F_Floppy-NPTH.drl]
2026-10-30 Use a flat mounting base for DB23 revision 0.5
    [DB23_Holder_v0.5.scad, DB23_Holder_v0.5.step, DB23_Holder_v0.5.stl]
2026-10-30 Tidy Amiga DB23 project documentation
    Describe the current adapter and flat base consistently in the README, BOM and handover. Keep revision 0.5 and all CAD and manufacturing files unchanged.
    Refresh the checksum manifest to match repository file bytes. Validation: 648 portable PCB checks, 62 relative documentation links and all 16 BOM entries checked.
    [BOM.csv]
2026-10-30 Maintain DB23 revision 0.5 project records
    Align the audit baseline with the descriptive commit titles and refresh the checksum manifest. All current design files and engineering outputs are retained unchanged.
    Validation: 648 portable PCB checks pass; 62 relative documentation links resolve; 125 file checksums verified.
2026-10-30 Simplify the DB23 cover and add pin-entry funnels for mechanical v0.6
    Remove the four thin cover projections, both hooks and the base catches. Use a thicker optional glue-on cover with broad locating tabs, and add 0.40 mm entry funnels to all 23 guides and the fit coupon.
    Regenerate coordinated CAD, print files, previews, drawings and documentation; remove superseded mechanical outputs and clip coupons. Preserve PCB revision 0.5 and all fabrication files unchanged.
    Validation: 273 saved-file mechanical checks, 648 portable PCB checks and 70 reference-layout checks pass. Four printable meshes are closed single components; six previews and five PDF pages reviewed. Revision 0.6 still requires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
    [BOM.csv, DB23_Cap_v0.5.step, DB23_Cap_v0.5.stl, DB23_Cap_v0.6.step, DB23_Cap_v0.6.stl, DB23_Clip_Fit_Base_v0.5.stl, DB23_Clip_Fit_Cap_v0.5.stl, DB23_Holder_v0.5.step]
2026-10-30 Add alternative v0.6 lid with central PCB support wall
    Recover the checked lid from the interrupted correction as separate STL, STEP and standalone OpenSCAD files with fit notes. Retain the 37.20 mm rear wall down to nominal PCB top Z6.75. Existing files remain unchanged.
    [DB23_Cap_v0.6_PCB_support.scad, DB23_Cap_v0.6_PCB_support.step, DB23_Cap_v0.6_PCB_support.stl]
2026-10-30 Add experimental universal DB23 PCB and record prototype order
    Publish the separate universal board, fabrication ZIP, preview and checks. Mark use at your own risk and record Paul's order of 20 JLCPCB boards on 30 October 2026. Physical fit and operation remain unverified; retain the existing variant boards.
    [DB23_Universal_Prototype-B_Cu.gbl, DB23_Universal_Prototype-B_Mask.gbs, DB23_Universal_Prototype-B_Silkscreen.gbo, DB23_Universal_Prototype-Edge_Cuts.gm1, DB23_Universal_Prototype-F_Cu.gtl, DB23_Universal_Prototype-F_Mask.gts, DB23_Universal_Prototype-F_Silkscreen.gto, DB23_Universal_Prototype-NPTH.drl]
2026-10-30 Record 30-board prototype order and selected assembly hardware
    Correct PCB quantity from 20 to 30. Record M3x12 screws, M3 stainless nuts and L11.5 header orders supplied by Paul. Document nominal untrimmed pin stack separately from the unchanged 10.70 mm CAD model.
2026-10-30 Record order of five male and five female DB23 connectors
